StrawsonDesign/EduRover/EduRover Solidworks/BBB Subassembly/BBB subassembly.sldasm

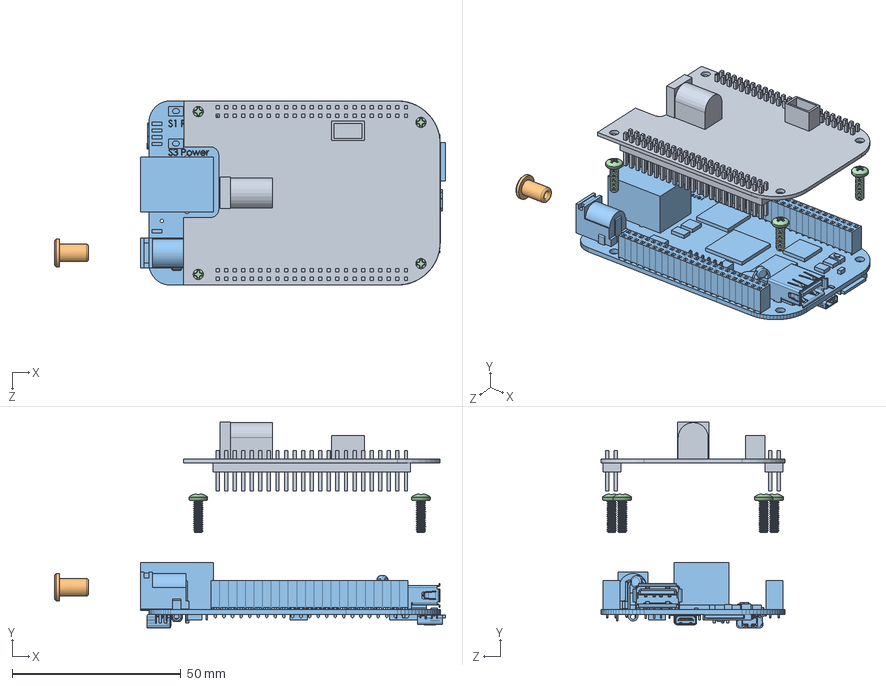
[picture p1: CAD file, 2015-09-28]
EduRover Solidworks/BBB Subassembly/BBB subassembly.sldasm
116.0 x 61.0 x 54.7 mm
SD-101C Robotics Cape
SD-105 DC Plug
BeagleBone Black Detailed
4-40 .375in BHCS McMaster 91772A108 x 4
