StrawsonDesign/EduRover/EduRover Solidworks/Corner Subassembly/corner subassembly with bearing.SLDASM

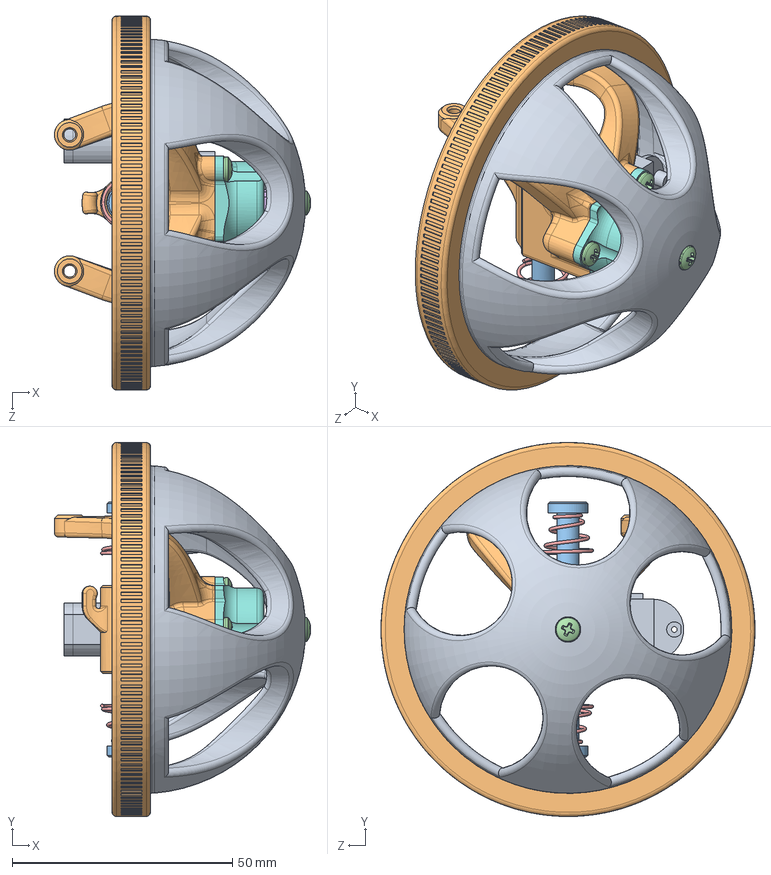
[picture p2: CAD file, 2015-10-05]
EduRover Solidworks/Corner Subassembly/corner subassembly with bearing.SLDASM
58.3 x 85.0 x 85.0 mm
WW Motor
SD-209 Knuckle
M4x20 Low Profile Shoulder Screw 90323A328 x 2
4-40 .375in BHCS McMaster 91772A108 x 4
0.375in conical spring 1692K51 x 2
spline adapter
WW bearing
SD-204 Wheel Bearing Retainer
SD-207 EduRover Wheel
Pololu 90mm Tire
