StrawsonDesign/EduRover/EduRover Solidworks/Servo Subassembly/servo subassembly.SLDASM

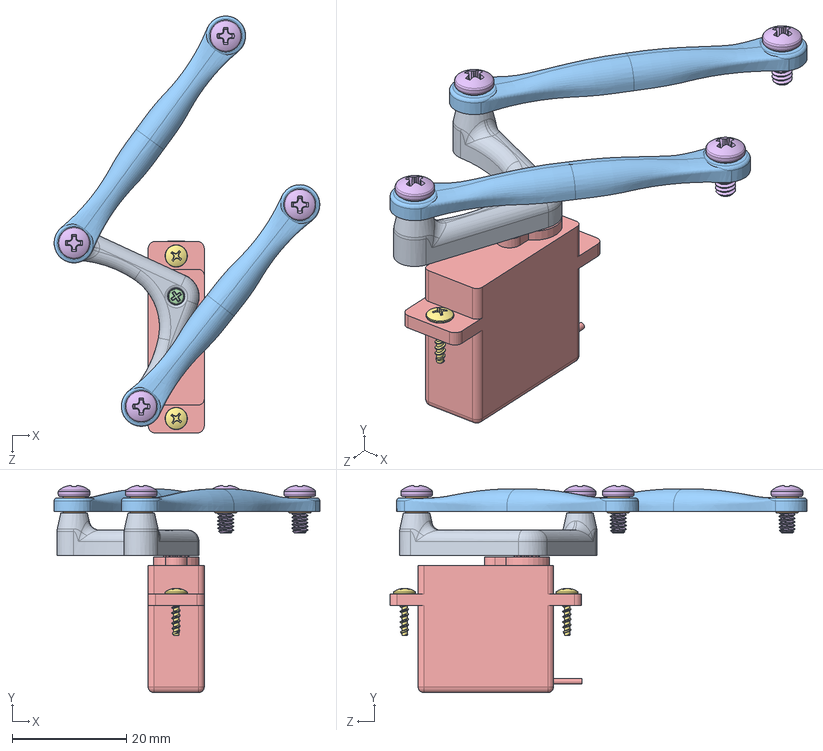
[picture p3: CAD file, 2015-09-28]
EduRover Solidworks/Servo Subassembly/servo subassembly.SLDASM
46.6 x 36.4 x 73.1 mm
SD-206 Servo Horn
ball linkage ball 4 40 x 4
SD-205 Steering Linkage x 2
Hitec servo screw
Hitec HS-45HB
4-40 0.25in BHCS McMaster 91772A106 x 4
Hitec Mounting Screws ROUGH x 2
