StrawsonDesign/EduRover/EduRover Solidworks/accessories/accessories.SLDASM

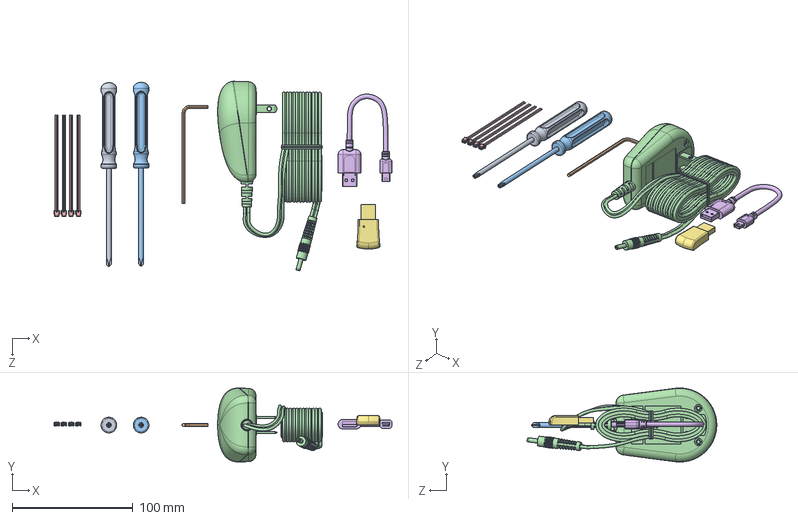
[picture p4: CAD file, 2015-09-28]
EduRover Solidworks/accessories/accessories.SLDASM
280.1 x 61.3 x 157.1 mm
Philips Screwdriver P2
2.5mm allan key
Philips Screwdriver P0
12v 1A DC power supply
JST ZH 2-Pin Pigtail x 4
mini usb cable
Bluetooth Dongle
