StrawsonDesign/EduRover/EduRover Solidworks/Chassis Subassembly/chassis subassembly.SLDASM

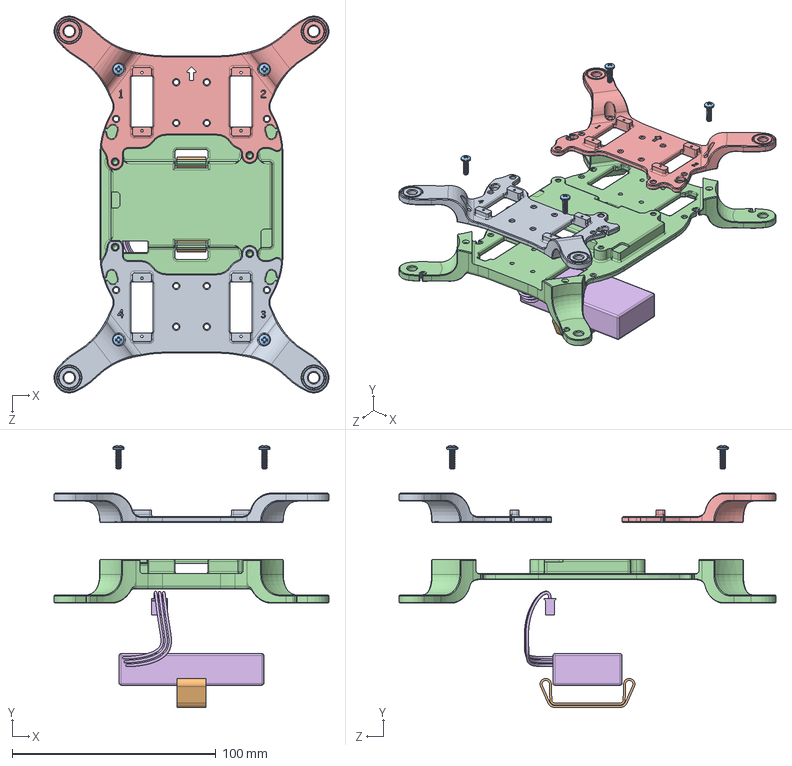
[picture p5: CAD file, 2015-09-28]
EduRover Solidworks/Chassis Subassembly/chassis subassembly.SLDASM
135.0 x 128.7 x 185.0 mm
SD-203 Chassis Back
velcro strap
4-40 .375in BHCS McMaster 91772A108 x 4
SD-202 Chassis Bottom
SD-201 Chassis Front
EduLine 1400mah Battery
