StrawsonDesign/EduRover/EduRover Solidworks/Servo Subassembly/ball linkage 4 40.SLDASM

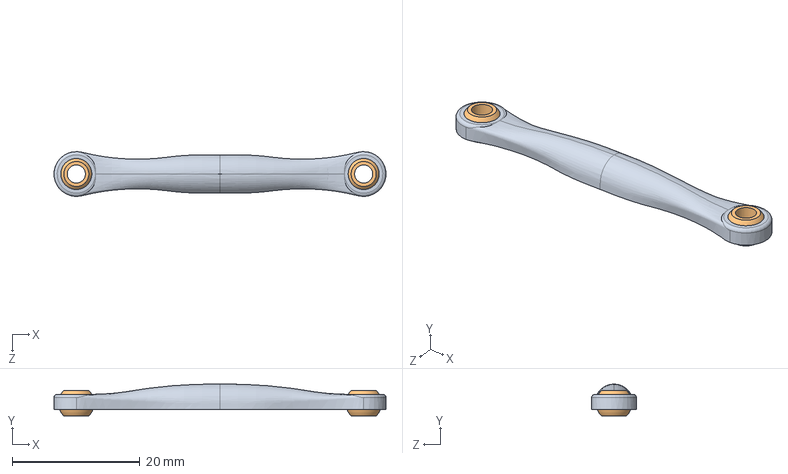
[picture p6: CAD file, 2015-09-28]
EduRover Solidworks/Servo Subassembly/ball linkage 4 40.SLDASM
52.0 x 5.00 x 7.00 mm
ball linkage ball 4 40 x 2
SD-205 Steering Linkage
