StrawsonDesign/EduRover/EduRover Solidworks/accessories/JST ZH 2-Pin Pigtail.SLDPRT

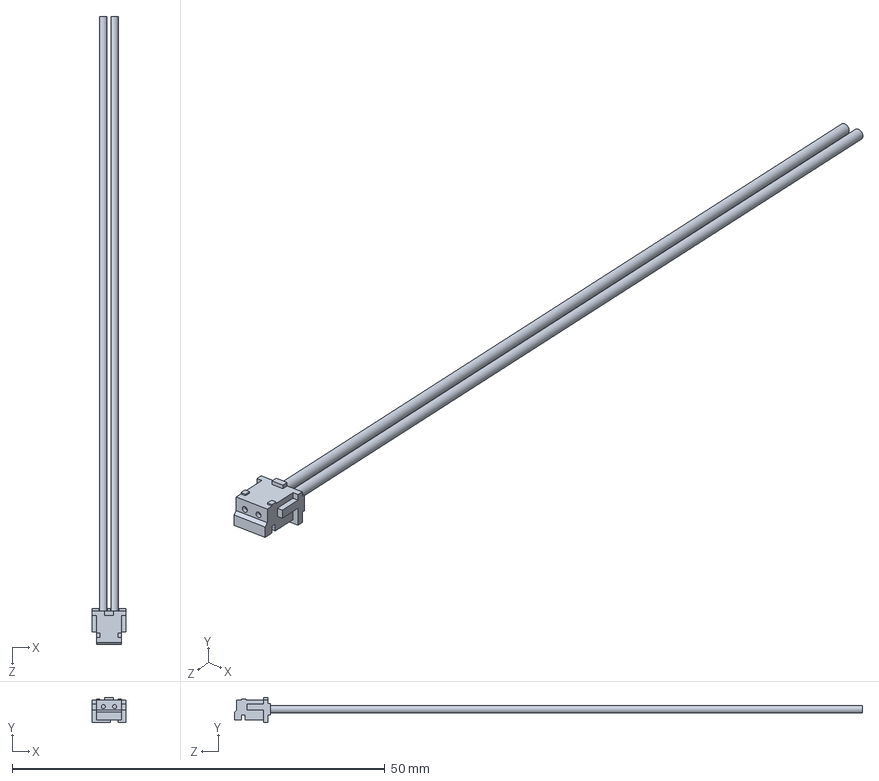
[picture p7: CAD file, 2015-09-28]
EduRover Solidworks/accessories/JST ZH 2-Pin Pigtail.SLDPRT
4.50 x 3.40 x 84.2 mm
