StrawsonDesign/EduRover/EduRover Solidworks/Chassis Subassembly/EduLine 1400mah Battery.SLDPRT

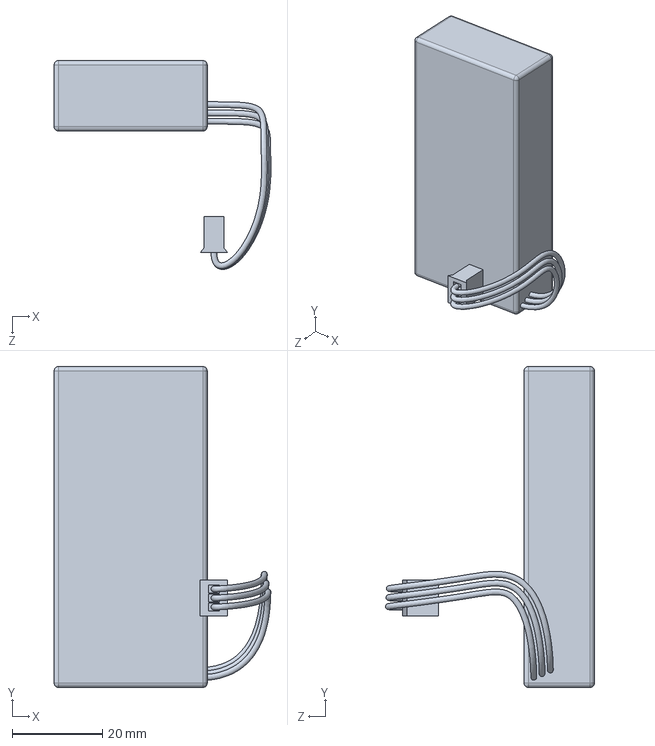
[picture p8: CAD file, 2015-09-28]
EduRover Solidworks/Chassis Subassembly/EduLine 1400mah Battery.SLDPRT
48.0 x 71.0 x 46.2 mm
