StrawsonDesign/EduRover/EduRover Solidworks/hardware/MiP bearing.SLDPRT

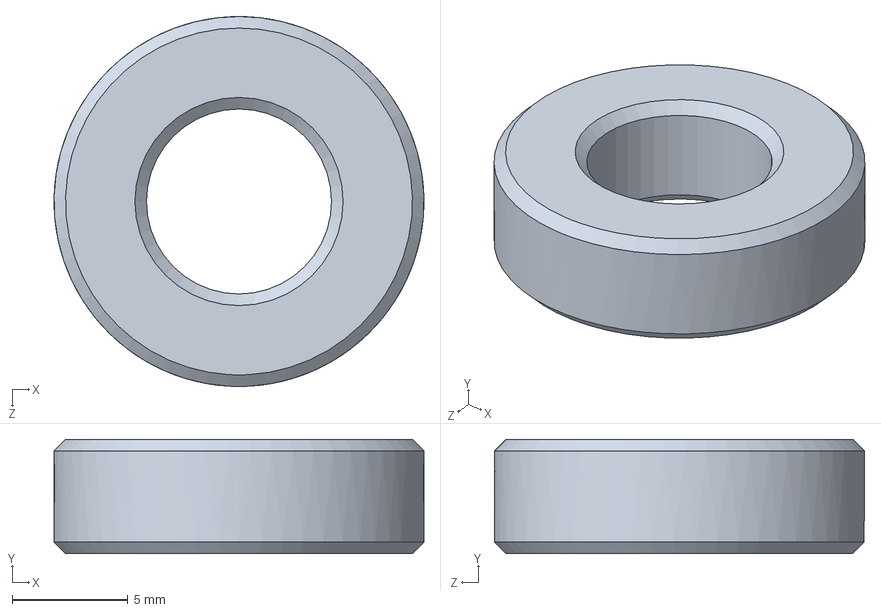
[picture p9: CAD file, 2015-09-28]
EduRover Solidworks/hardware/MiP bearing.SLDPRT
16.0 x 4.95 x 16.0 mm
