StrawsonDesign/EduRover/EduRover STL for printing/SD-209 Knuckle.STL

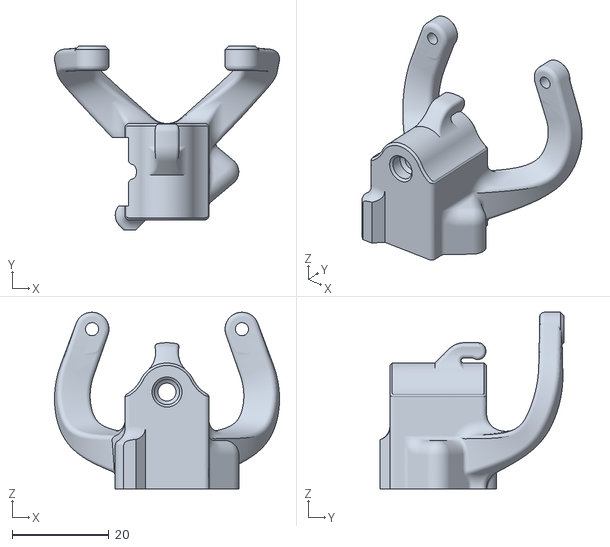
[picture p10: CAD file, 2015-10-05]
EduRover STL for printing/SD-209 Knuckle.STL
46.5 x 38.0 x 36.5
