StrawsonDesign/EduRover/EduRover Solidworks/accessories/2.5mm allan key.SLDPRT

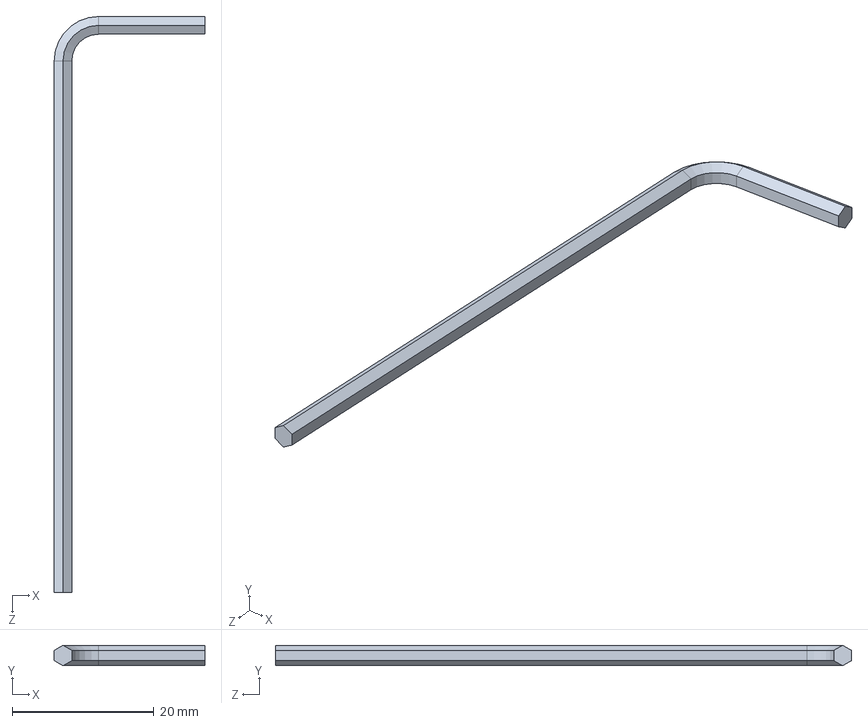
[picture p11: CAD file, 2015-09-28]
EduRover Solidworks/accessories/2.5mm allan key.SLDPRT
21.2 x 2.89 x 81.2 mm
