StrawsonDesign/EduRover/EduRover Solidworks/BBB Subassembly/SD-101C Robotics Cape.SLDPRT

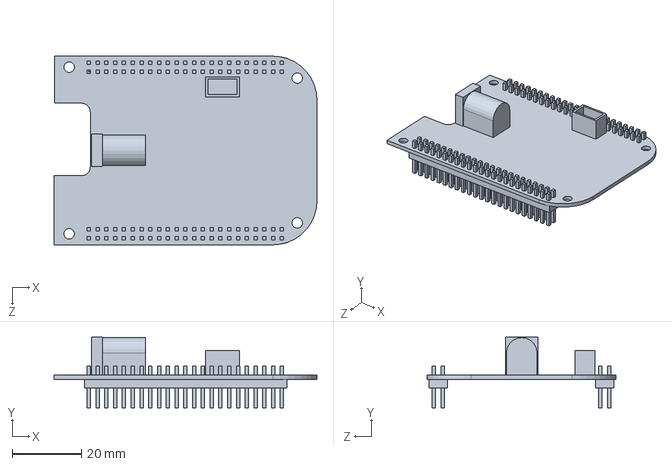
[picture p12: CAD file, 2015-09-28]
EduRover Solidworks/BBB Subassembly/SD-101C Robotics Cape.SLDPRT
76.1 x 20.5 x 54.6 mm
