StrawsonDesign/EduRover/EduRover Solidworks/Chassis Subassembly/velcro strap.SLDPRT

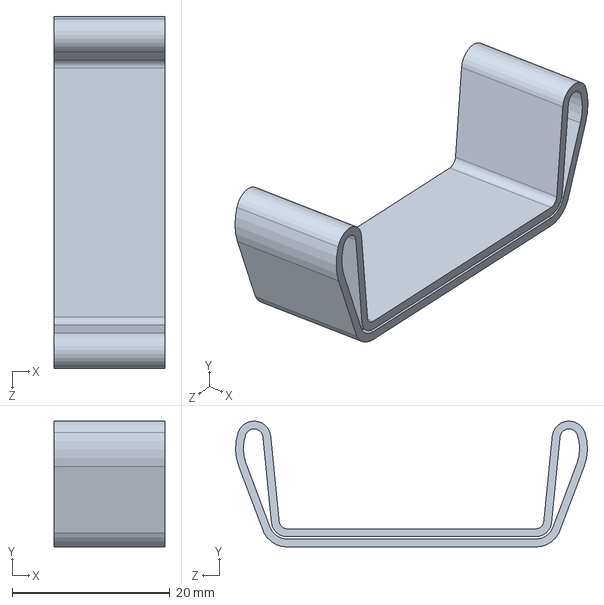
[picture p13: CAD file, 2015-09-28]
EduRover Solidworks/Chassis Subassembly/velcro strap.SLDPRT
14.0 x 15.9 x 44.6 mm
