StrawsonDesign/EduRover/EduRover Solidworks/Servo Subassembly/Hitec HS-45HB.SLDPRT

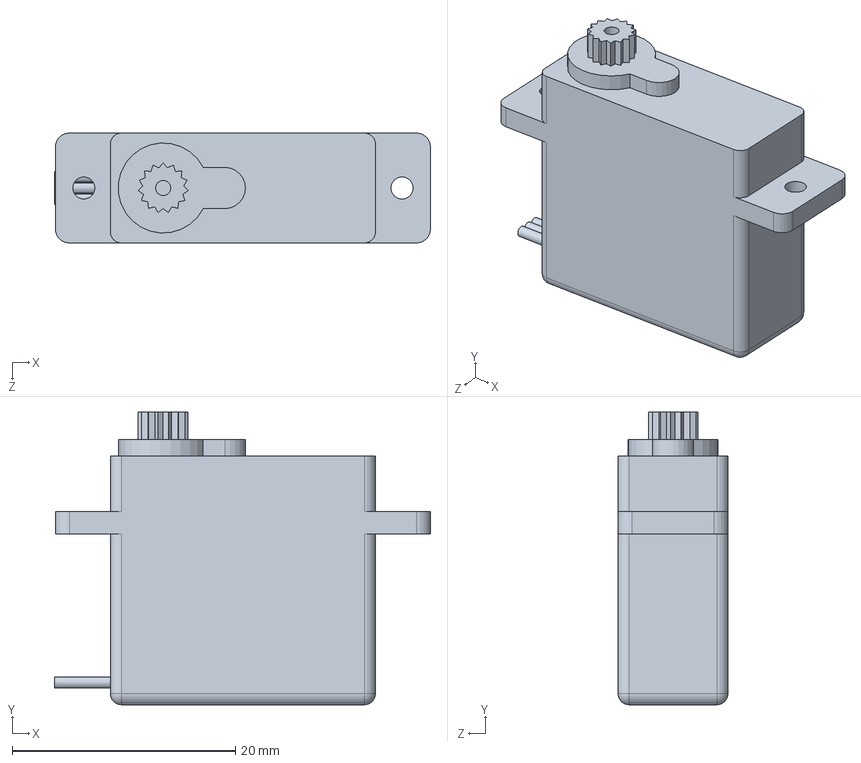
[picture p14: CAD file, 2015-09-28]
EduRover Solidworks/Servo Subassembly/Hitec HS-45HB.SLDPRT
33.7 x 26.2 x 9.85 mm
