StrawsonDesign/EduRover/EduRover STL for printing/SD-205 Steering Linkage.STL

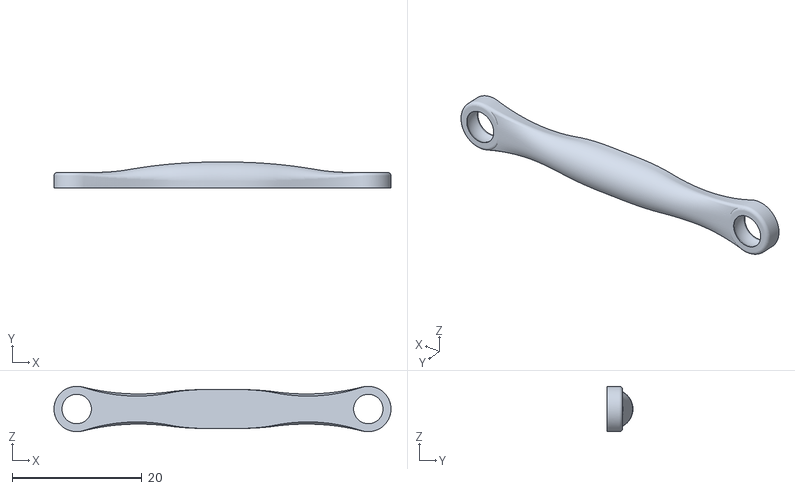
[picture p15: CAD file, 2015-09-28]
EduRover STL for printing/SD-205 Steering Linkage.STL
52.0 x 4.00 x 7.00
