StrawsonDesign/EduRover/EduRover Solidworks/accessories/3mm allan key.SLDPRT

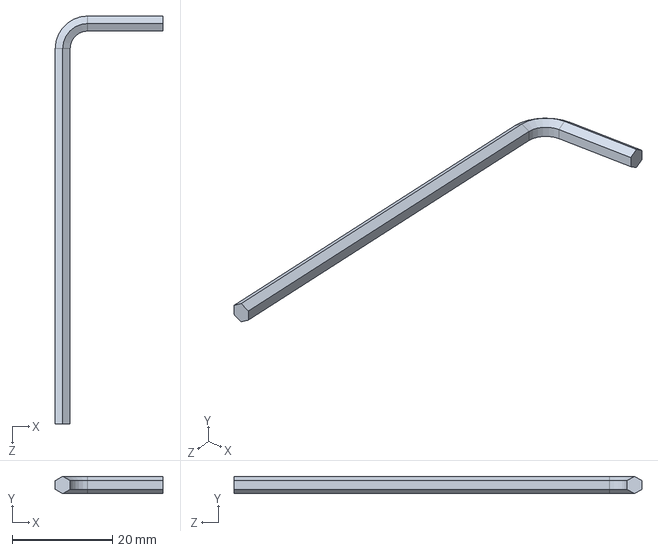
[picture p16: CAD file, 2015-09-28]
EduRover Solidworks/accessories/3mm allan key.SLDPRT
21.5 x 3.46 x 81.5 mm
