StrawsonDesign/EduRover/EduRover Solidworks/BBB Subassembly/SD-105 DC Plug.SLDPRT

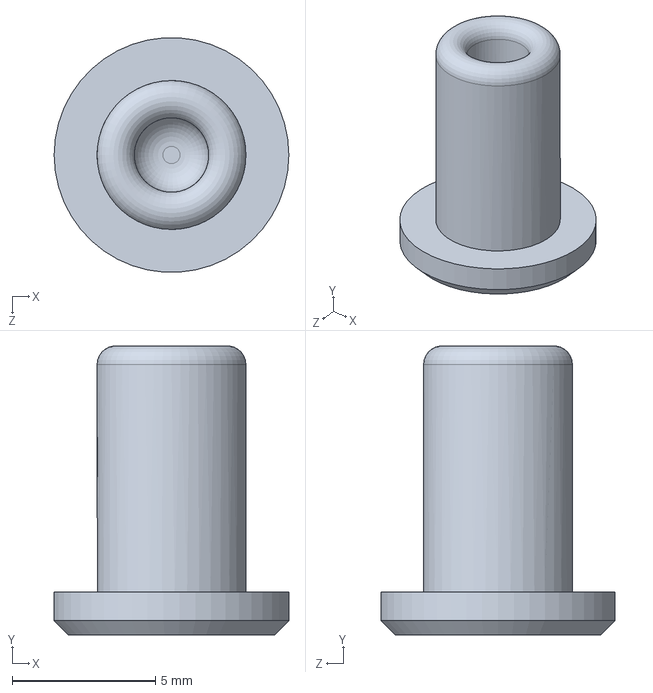
[picture p17: CAD file, 2015-09-28]
EduRover Solidworks/BBB Subassembly/SD-105 DC Plug.SLDPRT
8.20 x 10.1 x 8.18 mm
