StrawsonDesign/EduRover/EduRover Solidworks/Chassis Subassembly/SD-201 Chassis Front.SLDPRT

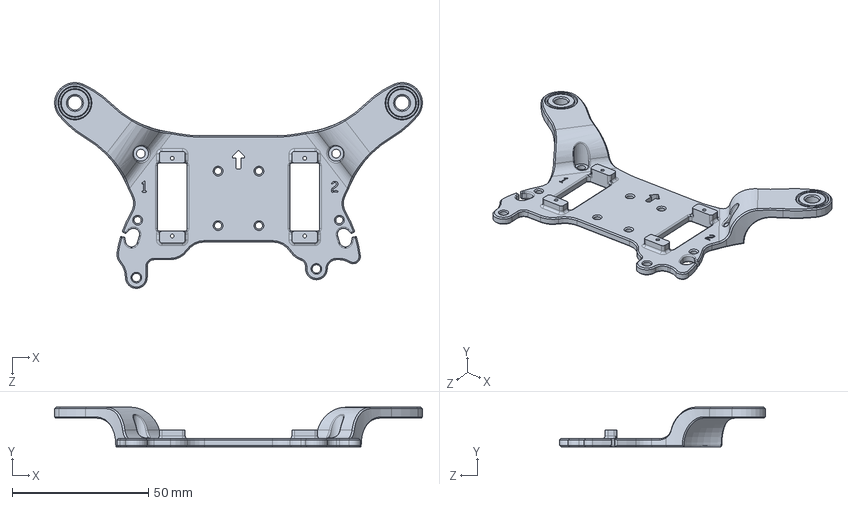
[picture p18: CAD file, 2015-09-28]
EduRover Solidworks/Chassis Subassembly/SD-201 Chassis Front.SLDPRT
135.0 x 14.5 x 75.5 mm
