StrawsonDesign/EduRover/EduRover Solidworks/Corner Subassembly/WW bearing.SLDPRT

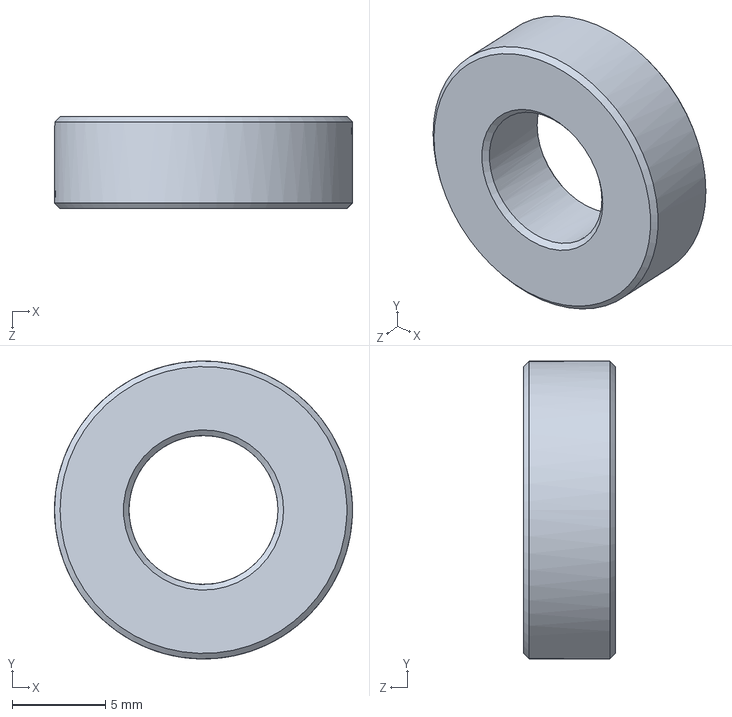
[picture p19: CAD file, 2015-09-28]
EduRover Solidworks/Corner Subassembly/WW bearing.SLDPRT
16.0 x 16.0 x 4.95 mm
