StrawsonDesign/EduRover/EduRover Solidworks/hardware/0.375in conical spring 1692K510.SLDPRT

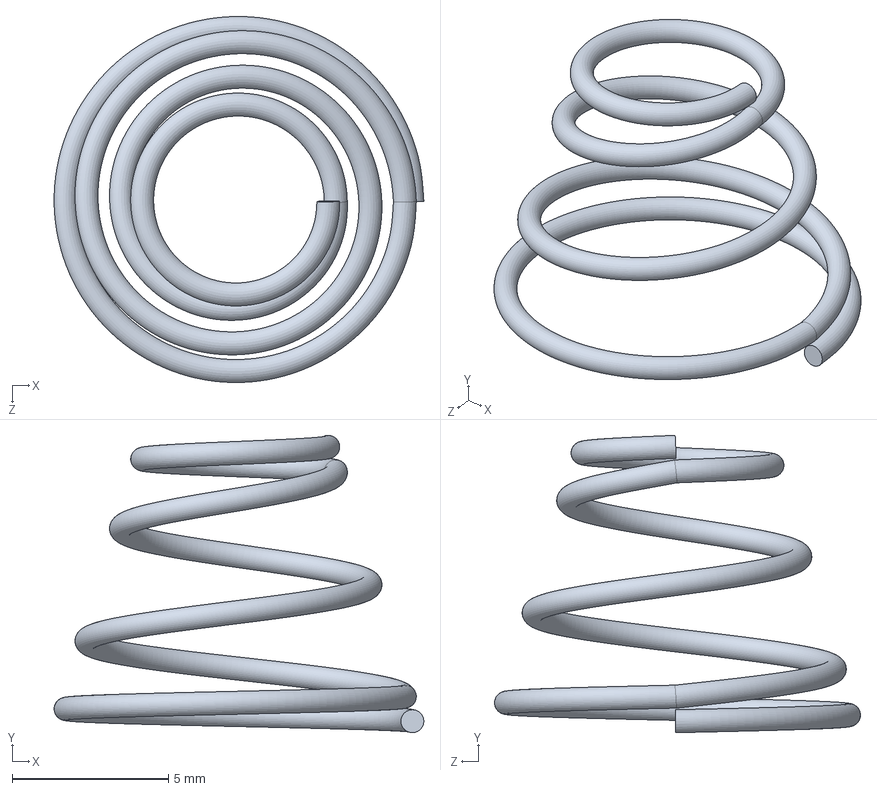
[picture p20: CAD file, 2015-09-28]
EduRover Solidworks/hardware/0.375in conical spring 1692K510.SLDPRT
11.8 x 9.53 x 11.7 mm
