StrawsonDesign/EduRover/EduRover Solidworks/Servo Subassembly/SD-206 Servo Horn.SLDPRT

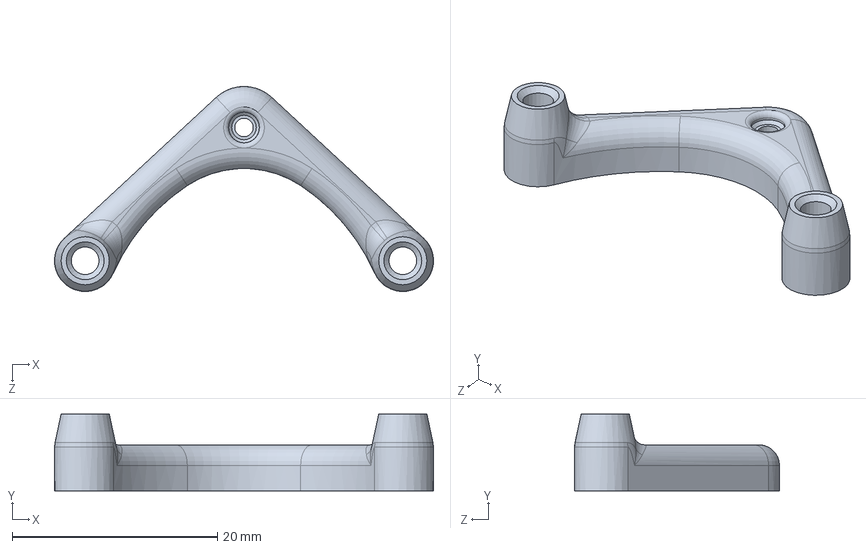
[picture p21: CAD file, 2015-09-28]
EduRover Solidworks/Servo Subassembly/SD-206 Servo Horn.SLDPRT
37.0 x 7.50 x 20.0 mm
