StrawsonDesign/EduRover/EduRover STL for printing/SD-203 Chassis Back.STL

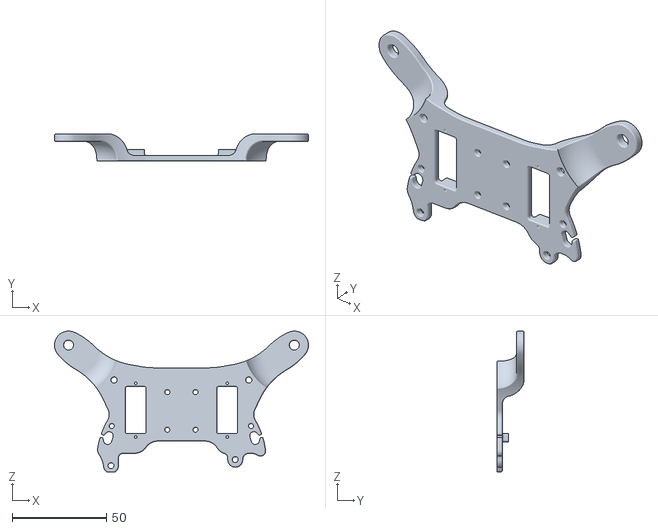
[picture p22: CAD file, 2015-09-28]
EduRover STL for printing/SD-203 Chassis Back.STL
135.0 x 14.5 x 74.8
