StrawsonDesign/EduRover/EduRover Solidworks/Chassis Subassembly/Turnigy Nanotech 1300mah 2S N1300.2S.25.SLDPRT

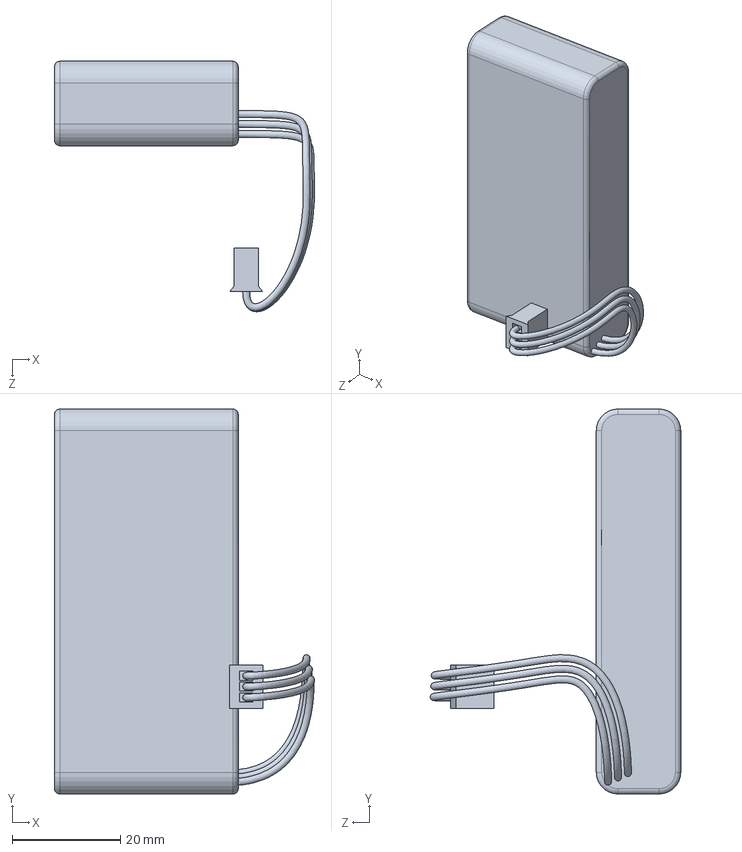
[picture p23: CAD file, 2015-09-28]
EduRover Solidworks/Chassis Subassembly/Turnigy Nanotech 1300mah 2S N1300.2S.25.SLDPRT
48.0 x 71.0 x 46.2 mm
