StrawsonDesign/EduRover/EduRover Solidworks/Corner Subassembly/SD-207 EduRover Wheel.SLDPRT

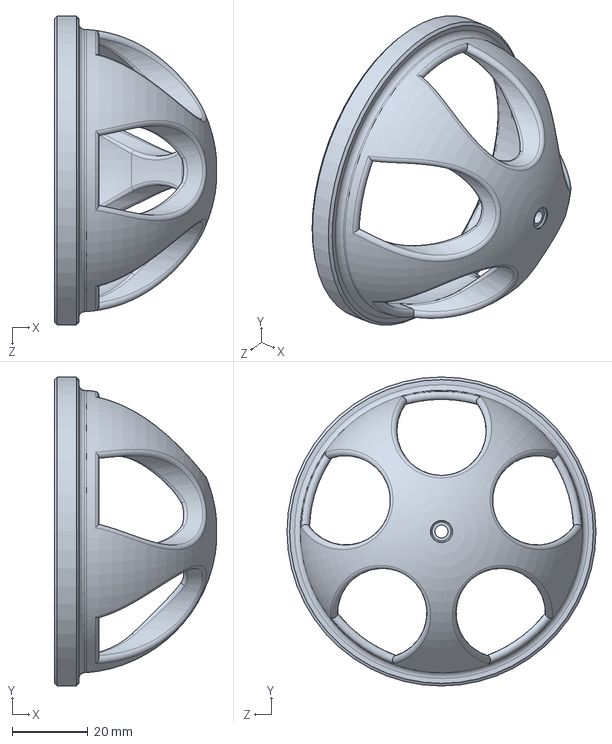
[picture p24: CAD file, 2015-09-28]
EduRover Solidworks/Corner Subassembly/SD-207 EduRover Wheel.SLDPRT
42.8 x 81.4 x 81.4 mm
