StrawsonDesign/EduRover/EduRover STL for printing/SD-204 Wheel Bearing Retainer.STL

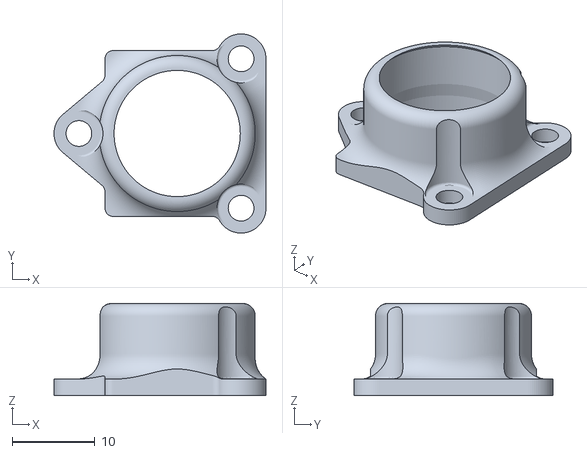
[picture p25: CAD file, 2015-09-28]
EduRover STL for printing/SD-204 Wheel Bearing Retainer.STL
25.5 x 24.0 x 11.1
