StrawsonDesign/EduRover/EduRover Solidworks/accessories/12v 1A DC power supply.SLDPRT

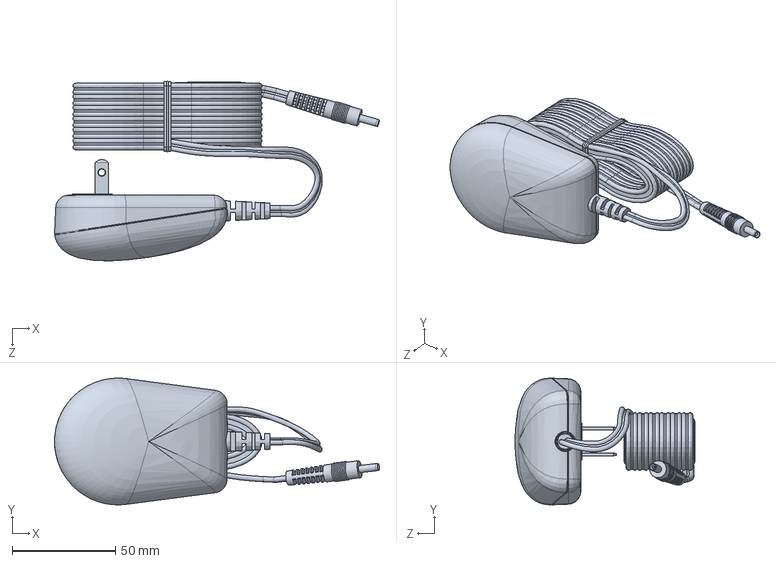
[picture p26: CAD file, 2015-09-28]
EduRover Solidworks/accessories/12v 1A DC power supply.SLDPRT
157.1 x 61.3 x 87.0 mm
