StrawsonDesign/EduRover/EduRover Solidworks/Corner Subassembly/WW Motor.SLDPRT

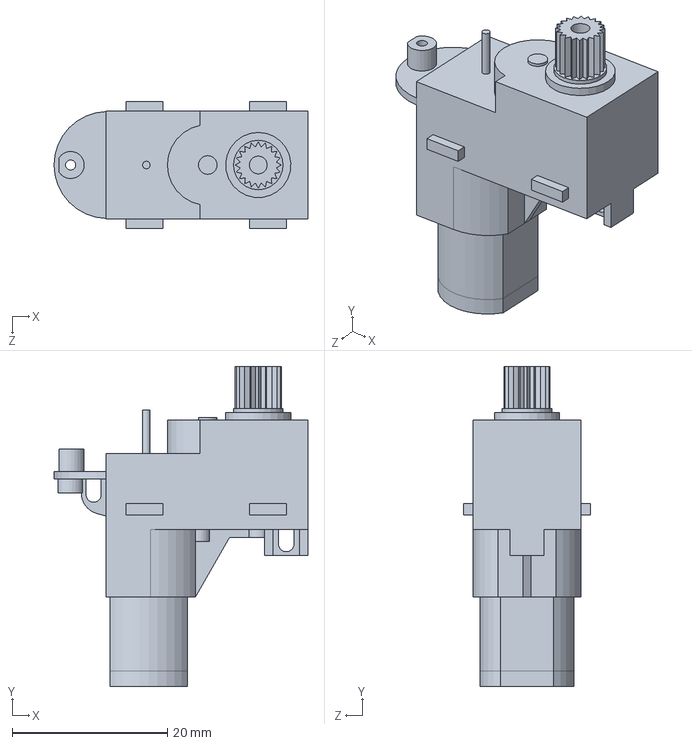
[picture p27: CAD file, 2015-09-28]
EduRover Solidworks/Corner Subassembly/WW Motor.SLDPRT
32.7 x 41.2 x 16.3 mm
