StrawsonDesign/EduRover/EduRover Solidworks/Servo Subassembly/ball linkage ball 4 40.SLDPRT

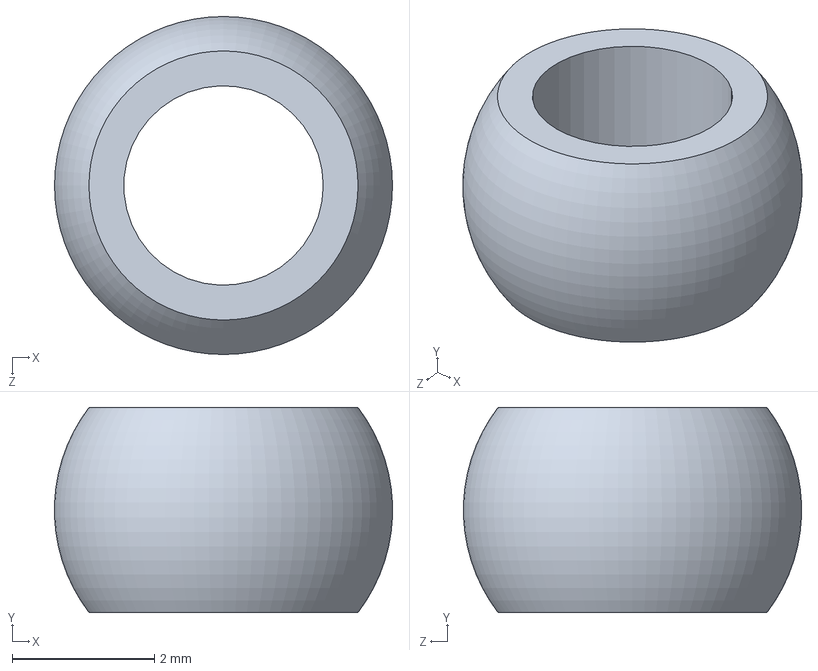
[picture p28: CAD file, 2015-09-28]
EduRover Solidworks/Servo Subassembly/ball linkage ball 4 40.SLDPRT
4.75 x 2.88 x 4.75 mm
