StrawsonDesign/EduRover/EduRover Solidworks/accessories/Bluetooth Dongle.SLDPRT

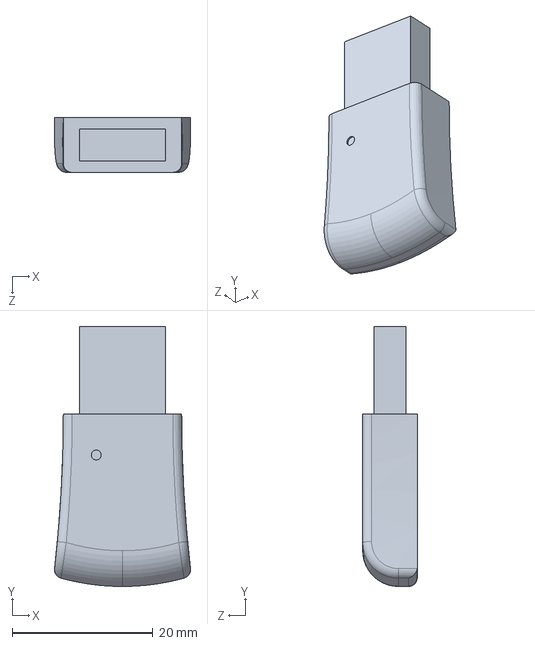
[picture p29: CAD file, 2015-09-28]
EduRover Solidworks/accessories/Bluetooth Dongle.SLDPRT
19.3 x 36.9 x 7.77 mm
