StrawsonDesign/EduRover/EduRover Solidworks/Corner Subassembly/Pololu 90mm Tire.SLDPRT

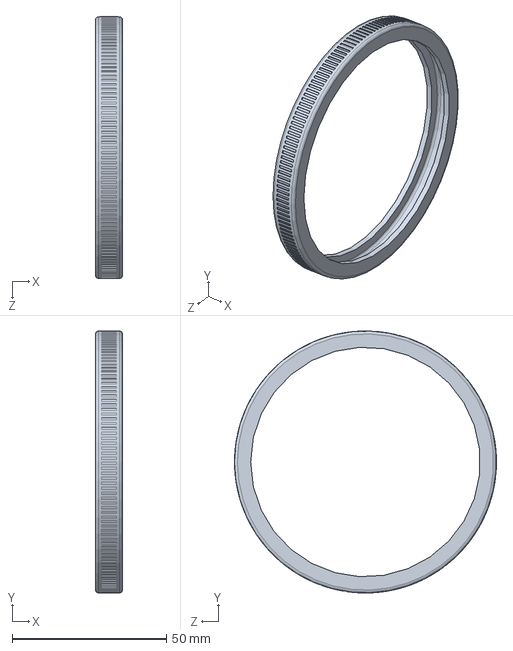
[picture p30: CAD file, 2015-09-28]
EduRover Solidworks/Corner Subassembly/Pololu 90mm Tire.SLDPRT
8.75 x 85.0 x 85.0 mm
