StrawsonDesign/EduRover/EduRover Solidworks/accessories/mini usb cable.SLDPRT

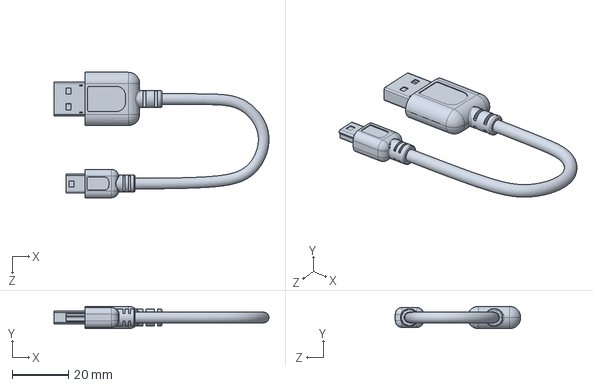
[picture p31: CAD file, 2015-09-28]
EduRover Solidworks/accessories/mini usb cable.SLDPRT
76.6 x 8.00 x 44.7 mm
