StrawsonDesign/EduRover/EduRover Solidworks/Chassis Subassembly/SD-202 Chassis Bottom.sldprt

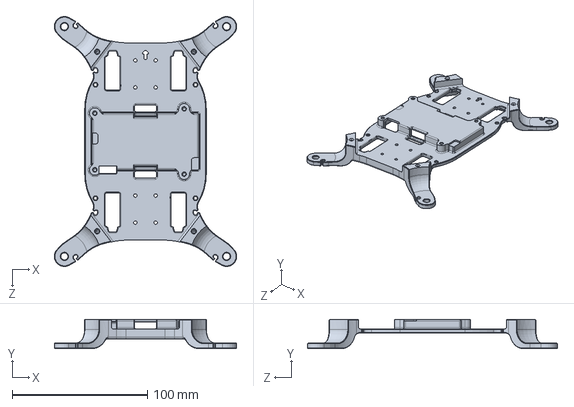
[picture p32: CAD file, 2015-09-28]
EduRover Solidworks/Chassis Subassembly/SD-202 Chassis Bottom.sldprt
135.0 x 21.5 x 185.0 mm
