StrawsonDesign/EduRover/EduRover Solidworks/Corner Subassembly/spline adapter.SLDPRT

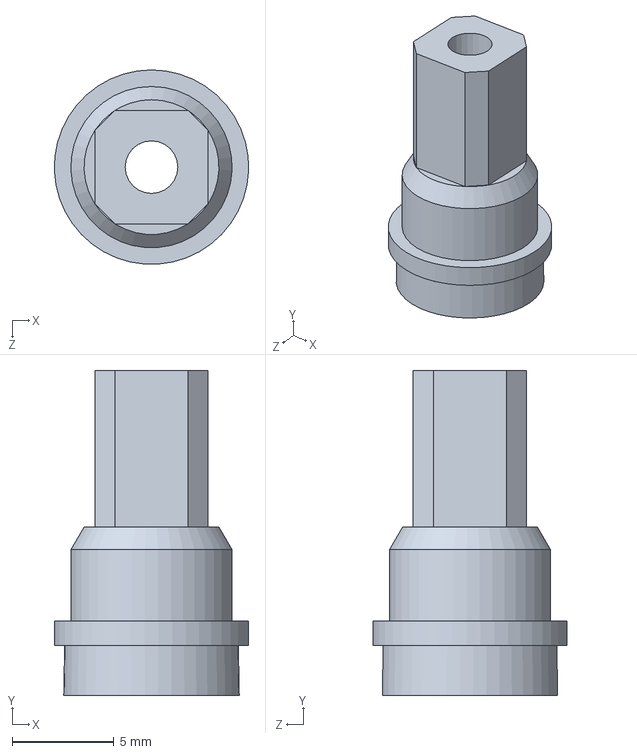
[picture p33: CAD file, 2015-09-28]
EduRover Solidworks/Corner Subassembly/spline adapter.SLDPRT
9.56 x 16.0 x 9.56 mm
