StrawsonDesign/EduRover/(list of files, cad)

Other CAD files:
EduRover Solidworks/Corner Subassembly/SD-209 Knuckle.SLDPRT
EduRover Solidworks/Servo Subassembly/SD-205 Steering Linkage.SLDPRT
EduRover STL for printing/SD-105 DC Plug.STL
EduRover Solidworks/Chassis Subassembly/SD-203 Chassis Back.sldprt
EduRover STL for printing/SD-206 Servo Horn.STL
EduRover STL for printing/SD-201 Chassis Front.STL
EduRover Solidworks/Corner Subassembly/SD-204 Wheel Bearing Retainer.SLDPRT
EduRover Solidworks/hardware/0.375in conical spring 1692K51.SLDPRT
EduRover Solidworks/EduRover Drawing.SLDDRW
EduRover Solidworks/Old Unused parts/2000mah LiPo battery.SLDPRT
EduRover Solidworks/Old Unused parts/BeagleBone Black Rough.SLDPRT
EduRover Solidworks/Old Unused parts/Hub.SLDPRT
EduRover Solidworks/Old Unused parts/cable wrap standoff.SLDPRT
EduRover Solidworks/Old Unused parts/chassis standoffs.SLDPRT
EduRover Solidworks/Old Unused parts/encoder board new for Rover.SLDPRT
EduRover Solidworks/Old Unused parts/encoder board.SLDPRT
EduRover Solidworks/Old Unused parts/encoder wheels.SLDPRT
EduRover Solidworks/Old Unused parts/new encoder wheel.SLDPRT
EduRover Solidworks/Servo Subassembly/Hitec Mounting Screws ROUGH.SLDPRT
EduRover Solidworks/accessories/Philips Screwdriver P0.SLDPRT
EduRover Solidworks/accessories/Philips Screwdriver P2.SLDPRT
EduRover Solidworks/hardware/4-40 .375in BHCS McMaster 91772A108.SLDPRT
EduRover Solidworks/hardware/4-40 0.25in BHCS McMaster 91772A106.SLDPRT
EduRover Solidworks/hardware/Hitec servo screw.SLDPRT
EduRover Solidworks/hardware/M4 x 16mm Low Profile SHoulder Screw 90323A327.SLDPRT
EduRover Solidworks/hardware/M4x20 Low Profile Shoulder Screw 90323A328.SLDPRT
EduRover Solidworks/hardware/servo washer.SLDPRT
