StrawsonDesign/EduRover/EduRover Drawing.PDF

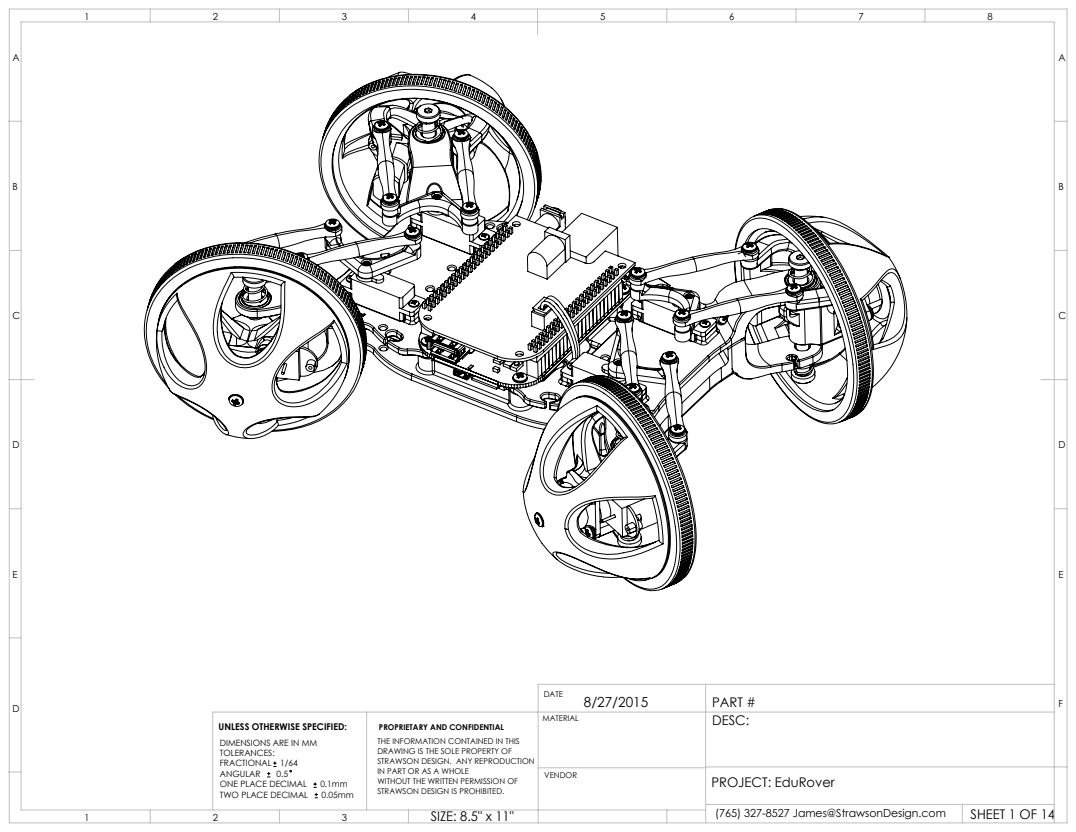
[picture p34: page 1]
SIZE: 8.5" x 11"; SHEET 1 OF 14

DATE 8/27/2015 | PART #

UNLESS OTHERWISE SPECIFIED: DIMENSIONS ARE IN MM TOLERANCES: FRACTIONAL 1/64 ANGULAR 0.5 ONE PLACE DECIMAL 0.1mm TWO PLACE DECIMAL 0.05mm | PROPRIETARY AND CONFIDENTIAL THE INFORMATION CONTAINED IN THIS DRAWING IS THE SOLE PROPERTY OF STRAWSON DESIGN. ANY REPRODUCTION IN PART OR AS A WHOLE WITHOUT THE WRITTEN PERMISSION OF STRAWSON DESIGN IS PROHIBITED. | MATERIAL | DESC:

VENDOR | PROJECT: EduRover

(765) 327-8527 James@StrawsonDesign.com

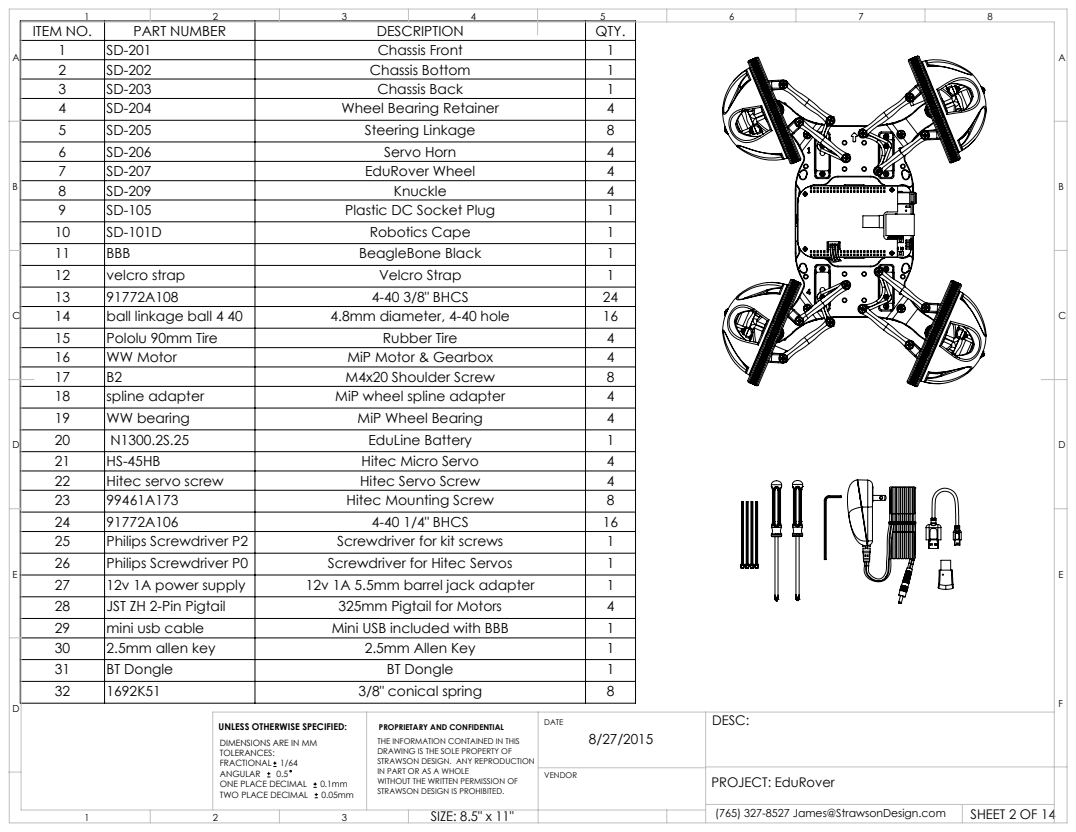
[picture p35: page 2]
ITEM NO.; PART NUMBER; DESCRIPTION; QTY.; SHEET 2 OF 14

1 | SD-201 | Chassis Front | 1
2 | SD-202 | Chassis Bottom | 1
3 | SD-203 | Chassis Back | 1
4 | SD-204 | Wheel Bearing Retainer | 4
B | 5 | SD-205 | Steering Linkage | 8 | B
6 | SD-206 | Servo Horn | 4
7 | SD-207 | EduRover Wheel | 4
8 | SD-209 | Knuckle | 4
9 | SD-105 | Plastic DC Socket Plug | 1
10 | SD-101D | Robotics Cape | 1
11 | BBB | BeagleBone Black | 1
12 | velcro strap | Velcro Strap | 1
13 | 91772A108 | 4-40 3/8" BHCS | 24
14 | ball linkage ball 4 40 | 4.8mm diameter, 4-40 hole | 16
15 | Pololu 90mm Tire | Rubber Tire | 4
16 | WW Motor | MiP Motor & Gearbox | 4
17 | B2 | M4x20 Shoulder Screw | 8
18 | spline adapter | MiP wheel spline adapter | 4
19 | WW bearing | MiP Wheel Bearing | 4
20 | N1300.2S.25 | EduLine Battery | 1
21 | HS-45HB | Hitec Micro Servo | 4
22 | Hitec servo screw | Hitec Servo Screw | 4
23 | 99461A173 | Hitec Mounting Screw | 8
E | 24 | 91772A106 | 4-40 1/4" BHCS | 16
25 | Philips Screwdriver P2 | Screwdriver for kit screws | 1
26 | Philips Screwdriver P0 | Screwdriver for Hitec Servos | 1
27 | 12v 1A power supply | 12v 1A 5.5mm barrel jack adapter | 1
28 | JST ZH 2-Pin Pigtail | 325mm Pigtail for Motors | 4
29 | mini usb cable | Mini USB included with BBB | 1
D | 30 | 2.5mm allen key | 2.5mm Allen Key | 1
31 | BT Dongle | BT Dongle | 1
32 | 1692K51 | 3/8" conical spring | 8

UNLESS OTHERWISE SPECIFIED:
DIMENSIONS ARE IN MM
TOLERANCES:
FRACTIONAL 1/64

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

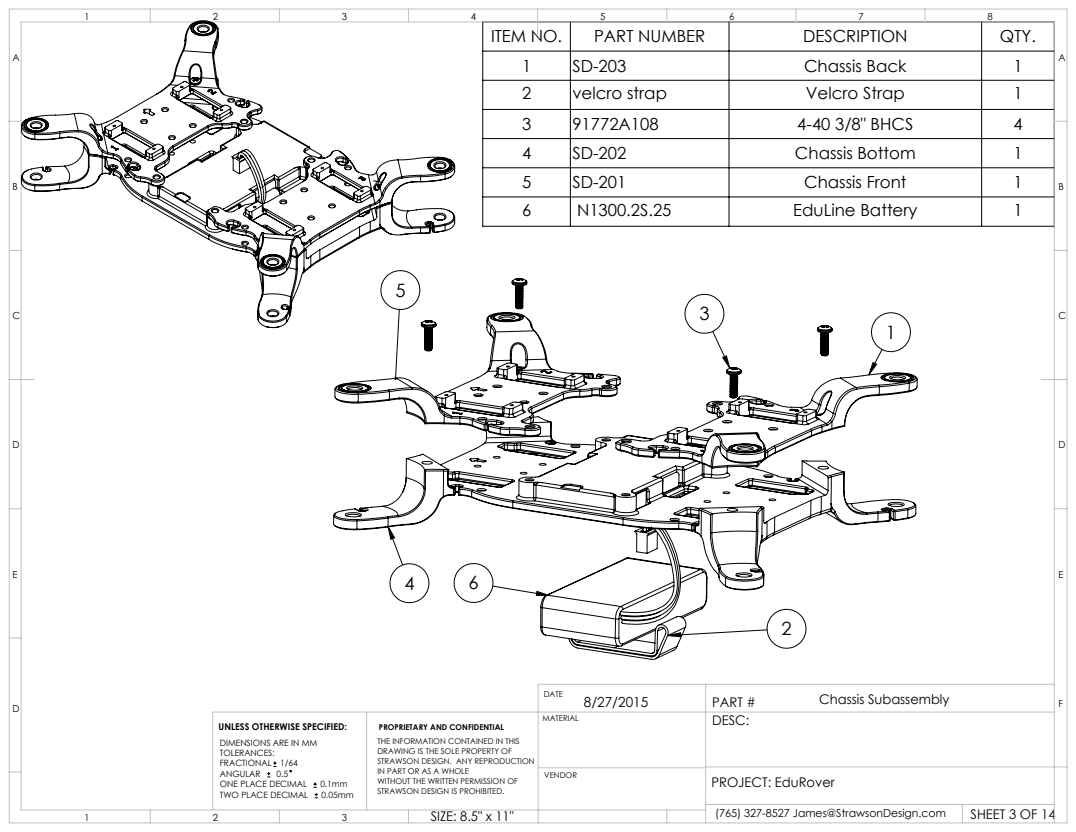
[picture p36: page 3]
SHEET 3 OF 14

1 | SD-203 | Chassis Back | 1
2 | velcro strap | Velcro Strap | 1
3 | 91772A108 | 4-40 3/8" BHCS | 4
4 | SD-202 | Chassis Bottom | 1
5 | SD-201 | Chassis Front | 1
6 | N1300.2S.25 | EduLine Battery | 1

DATE 8/27/2015 | Chassis Subassembly PART #

UNLESS OTHERWISE SPECIFIED: DIMENSIONS ARE IN MM TOLERANCES: FRACTIONAL 1/64 | PROPRIETARY AND CONFIDENTIAL THE INFORMATION CONTAINED IN THIS DRAWING IS THE SOLE PROPERTY OF STRAWSON DESIGN. ANY REPRODUCTION | MATERIAL | DESC:

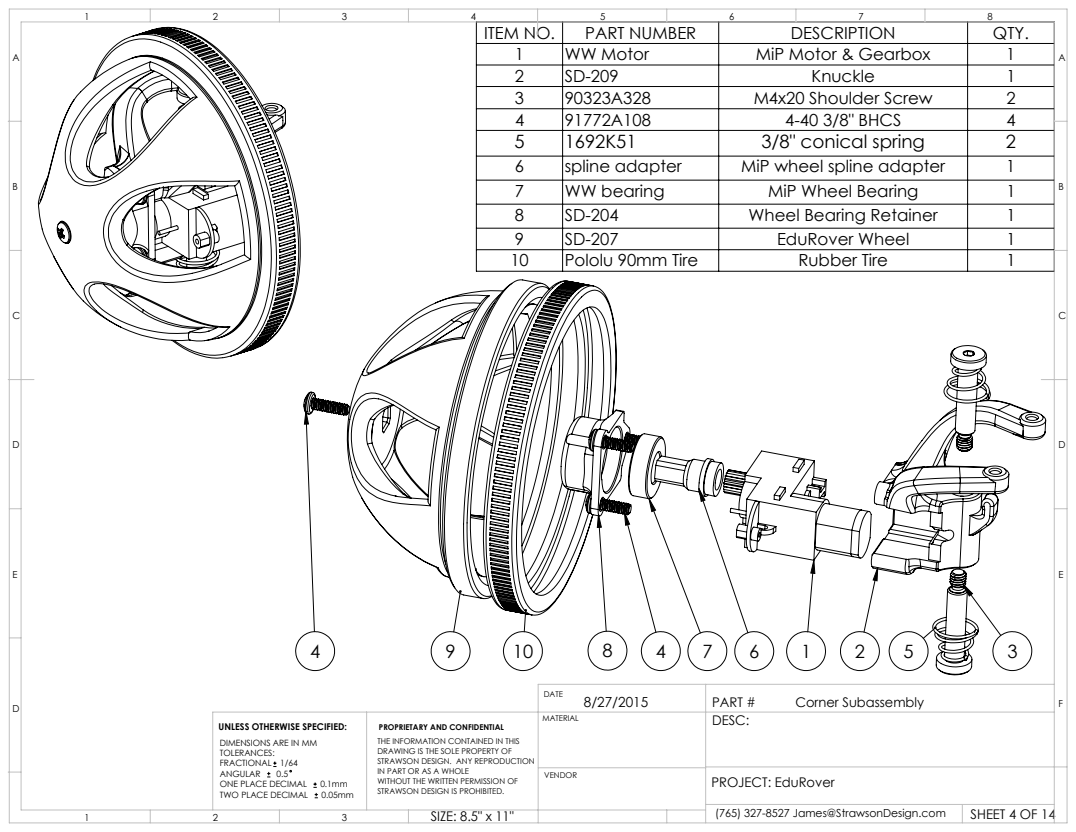
[picture p37: page 4]
SHEET 4 OF 14

1 | WW Motor | MiP Motor & Gearbox | 1
2 | SD-209 | Knuckle | 1
3 | 90323A328 | M4x20 Shoulder Screw | 2
4 | 91772A108 | 4-40 3/8" BHCS | 4
5 | 1692K51 | 3/8" conical spring | 2
6 | spline adapter | MiP wheel spline adapter | 1
7 | WW bearing | MiP Wheel Bearing | 1
8 | SD-204 | Wheel Bearing Retainer | 1
9 | SD-207 | EduRover Wheel | 1
10 | Pololu 90mm Tire | Rubber Tire | 1

DATE 8/27/2015 | Corner Subassembly PART #

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

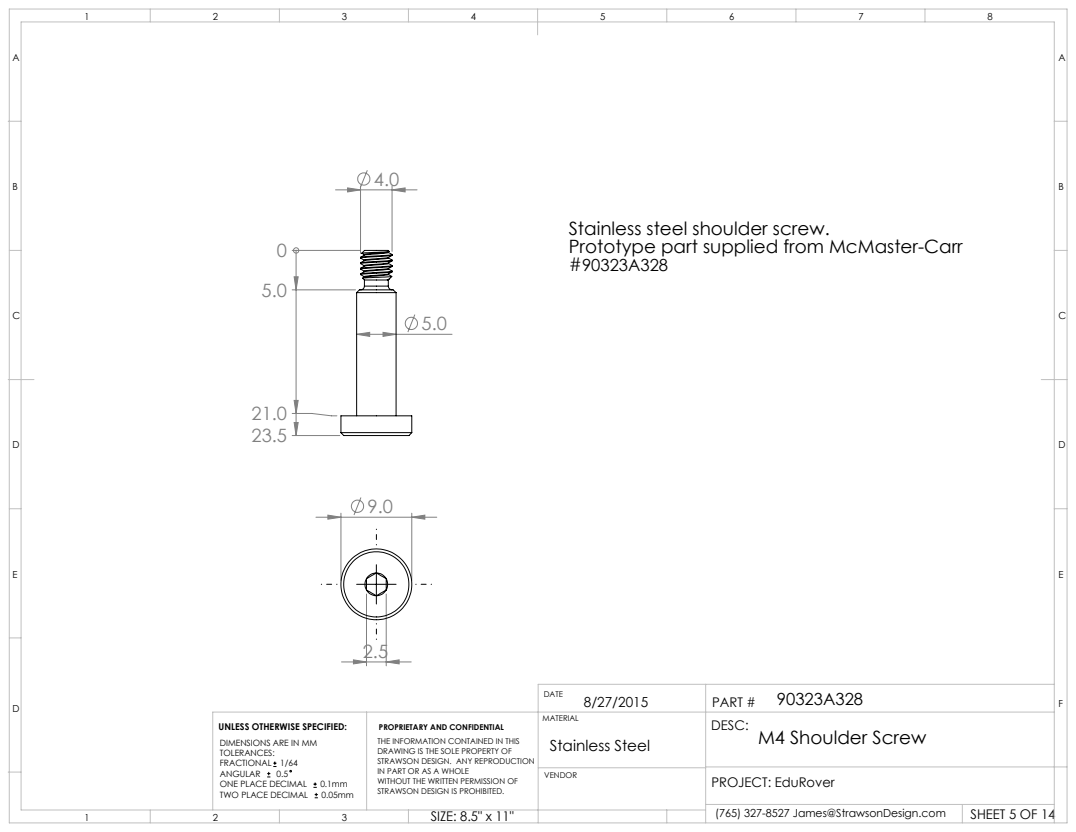
[picture p38: page 5]
SHEET 5 OF 14

Stainless steel shoulder screw.
Prototype part supplied from McMaster-Carr

DATE 8/27/2015 | 90323A328 PART #

UNLESS OTHERWISE SPECIFIED: DIMENSIONS ARE IN MM TOLERANCES: FRACTIONAL 1/64 | PROPRIETARY AND CONFIDENTIAL THE INFORMATION CONTAINED IN THIS DRAWING IS THE SOLE PROPERTY OF STRAWSON DESIGN. ANY REPRODUCTION | MATERIAL Stainless Steel | DESC: M4 Shoulder Screw

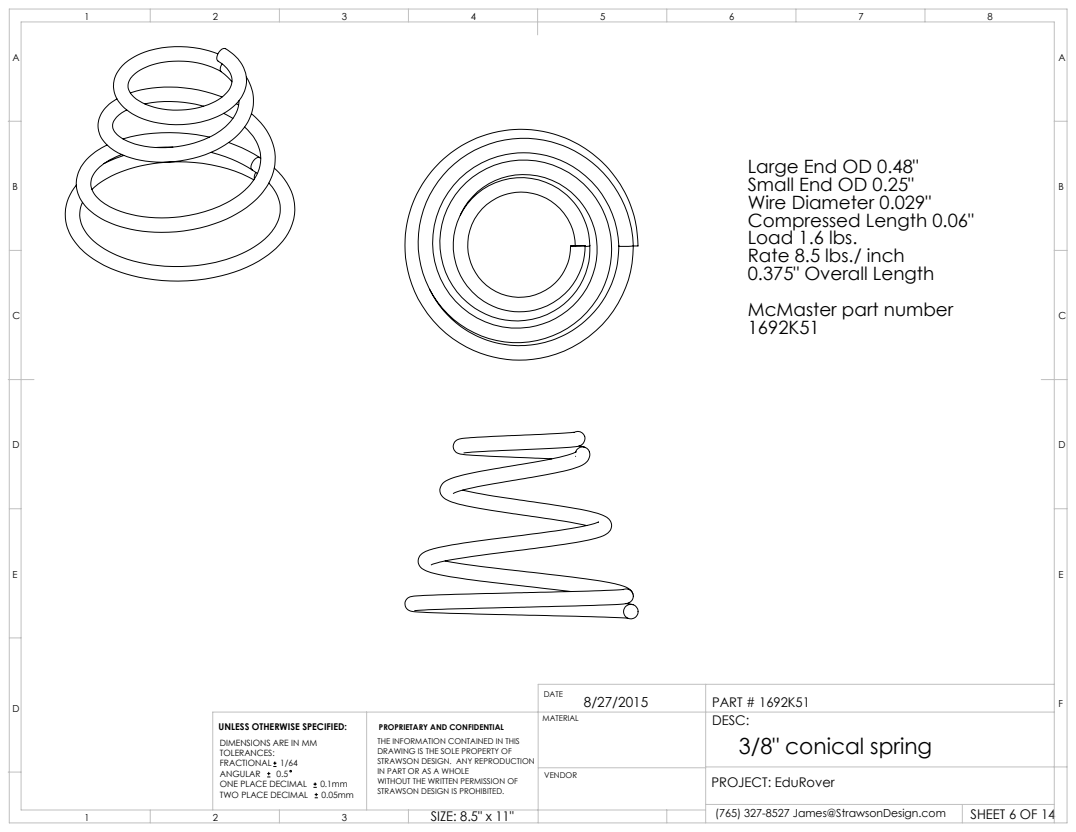
[picture p39: page 6]
SHEET 6 OF 14

Large End OD 0.48"
Small End OD 0.25"
Wire Diameter 0.029"
Compressed Length 0.06"
Load 1.6 lbs.
Rate 8.5 lbs./ inch
0.375" Overall Length
McMaster part number

DATE 8/27/2015 | PART # 1692K51

UNLESS OTHERWISE SPECIFIED: DIMENSIONS ARE IN MM TOLERANCES: FRACTIONAL 1/64 | PROPRIETARY AND CONFIDENTIAL THE INFORMATION CONTAINED IN THIS DRAWING IS THE SOLE PROPERTY OF STRAWSON DESIGN. ANY REPRODUCTION | MATERIAL | DESC: 3/8" conical spring

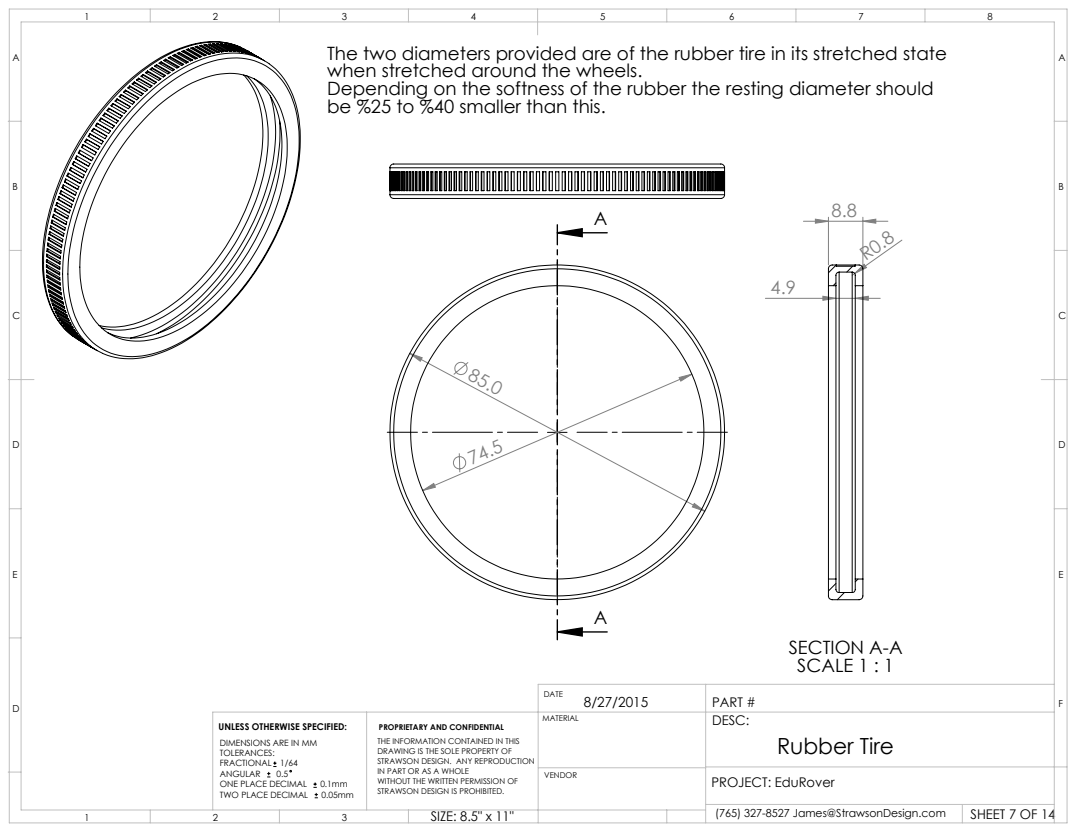
[picture p40: page 7]
SECTION A-A SCALE 1 : 1; SHEET 7 OF 14

The two diameters provided are of the rubber tire in its stretched state
when stretched around the wheels.
Depending on the softness of the rubber the resting diameter should
be %25 to %40 smaller than this.

DATE 8/27/2015 | PART #

UNLESS OTHERWISE SPECIFIED: DIMENSIONS ARE IN MM TOLERANCES: FRACTIONAL 1/64 | PROPRIETARY AND CONFIDENTIAL THE INFORMATION CONTAINED IN THIS DRAWING IS THE SOLE PROPERTY OF STRAWSON DESIGN. ANY REPRODUCTION | MATERIAL | DESC: Rubber Tire

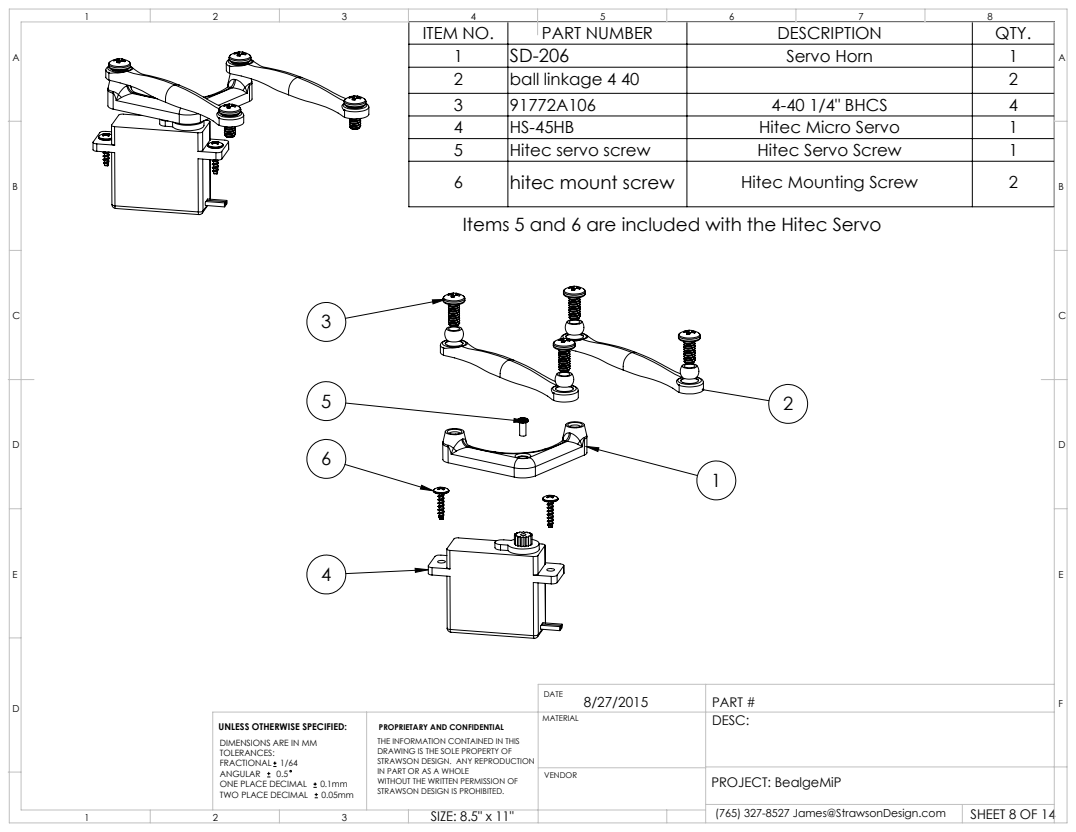
[picture p41: page 8]
SHEET 8 OF 14

1 | SD-206 | Servo Horn | 1
2 | ball linkage 4 40 | | 2
3 | 91772A106 | 4-40 1/4" BHCS | 4
4 | HS-45HB | Hitec Micro Servo | 1
5 | Hitec servo screw | Hitec Servo Screw | 1
6 | hitec mount screw | Hitec Mounting Screw | 2

Items 5 and 6 are included with the Hitec Servo

DATE 8/27/2015 | PART #

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

PROJECT: BealgeMiP

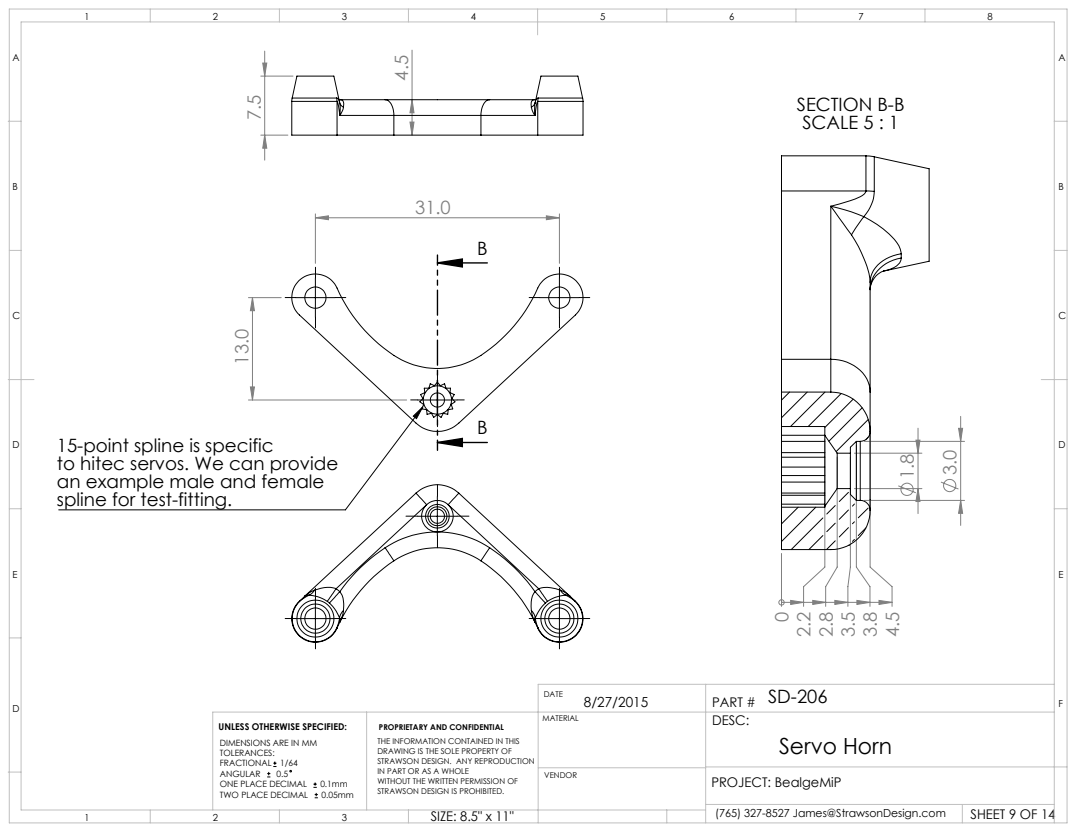
[picture p42: page 9]
SECTION B-B SCALE 5 : 1; SHEET 9 OF 14

15-point spline is specific
to hitec servos. We can provide
an example male and female
spline for test-fitting.

DATE 8/27/2015 | SD-206 PART #

UNLESS OTHERWISE SPECIFIED: DIMENSIONS ARE IN MM TOLERANCES: FRACTIONAL 1/64 | PROPRIETARY AND CONFIDENTIAL THE INFORMATION CONTAINED IN THIS DRAWING IS THE SOLE PROPERTY OF STRAWSON DESIGN. ANY REPRODUCTION | MATERIAL | DESC: Servo Horn

PROJECT: BealgeMiP

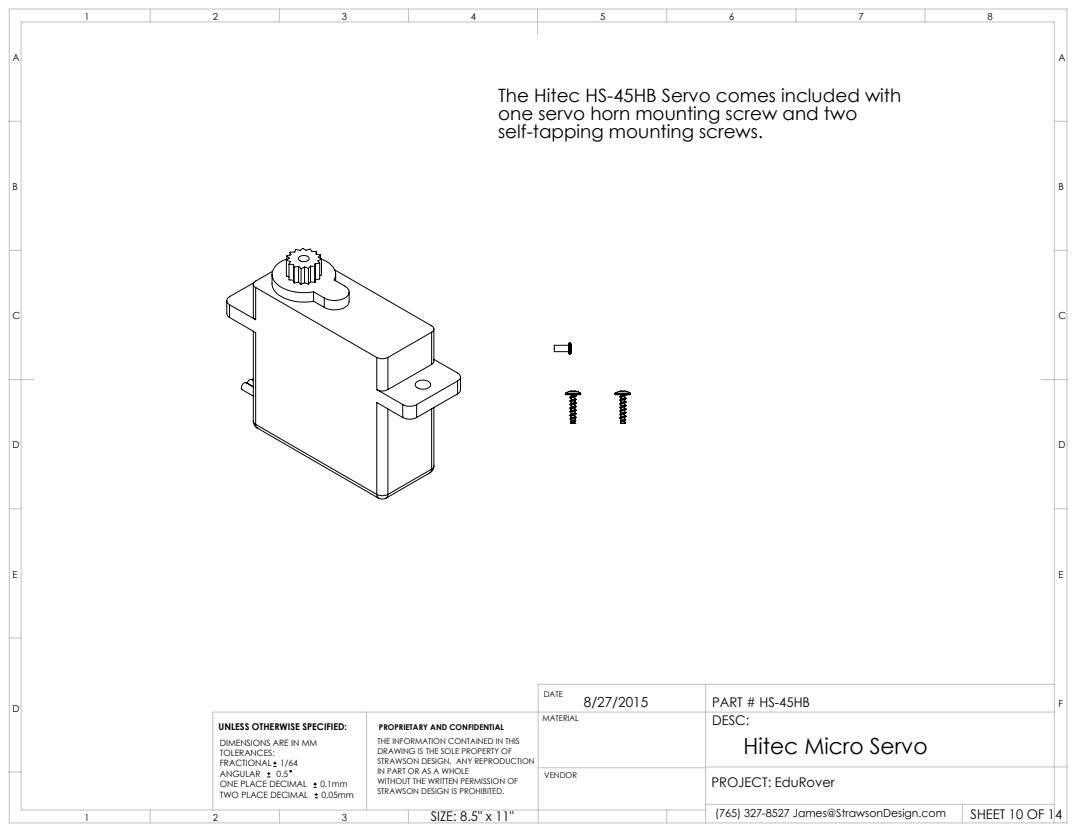
[picture p43: page 10]
SHEET 10 OF 14

The Hitec HS-45HB Servo comes included with
one servo horn mounting screw and two
self-tapping mounting screws.

DATE 8/27/2015 | PART # HS-45HB

UNLESS OTHERWISE SPECIFIED: DIMENSIONS ARE IN MM TOLERANCES: FRACTIONAL 1/64 | PROPRIETARY AND CONFIDENTIAL THE INFORMATION CONTAINED IN THIS DRAWING IS THE SOLE PROPERTY OF STRAWSON DESIGN. ANY REPRODUCTION | MATERIAL | DESC: Hitec Micro Servo

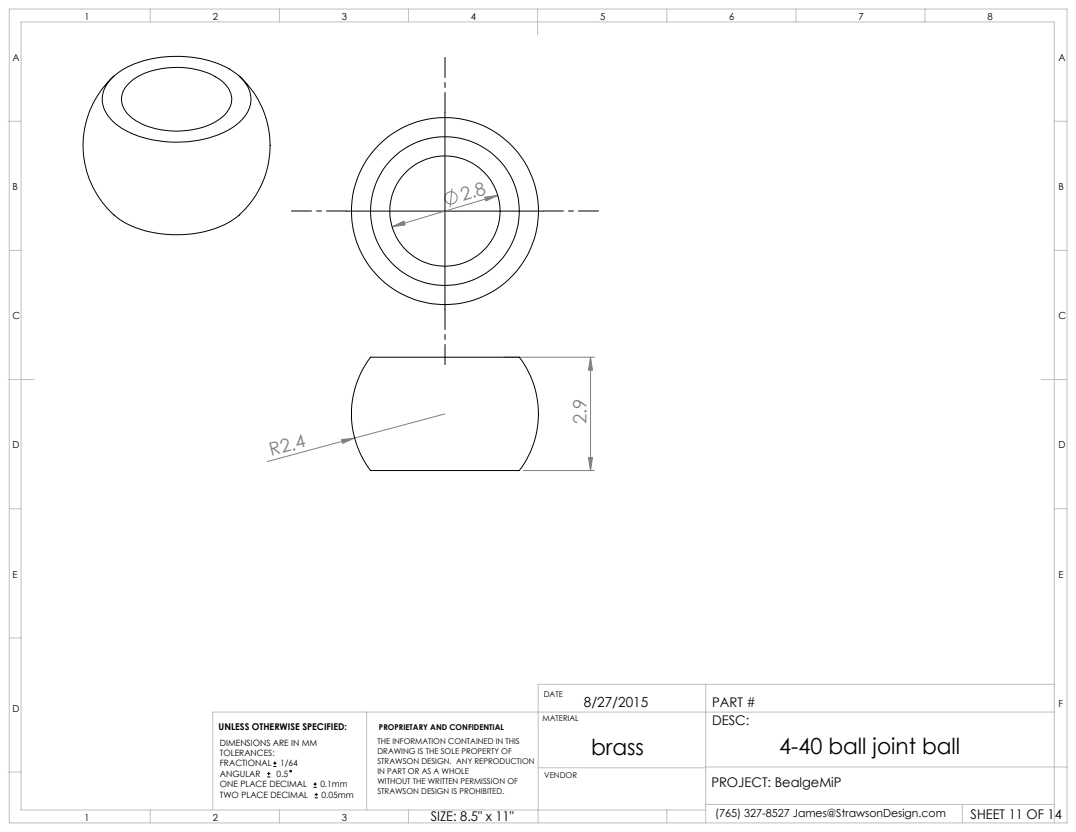
[picture p44: page 11]
SHEET 11 OF 14

DATE 8/27/2015 | PART #

UNLESS OTHERWISE SPECIFIED: DIMENSIONS ARE IN MM TOLERANCES: FRACTIONAL 1/64 | PROPRIETARY AND CONFIDENTIAL THE INFORMATION CONTAINED IN THIS DRAWING IS THE SOLE PROPERTY OF STRAWSON DESIGN. ANY REPRODUCTION | MATERIAL brass | DESC: 4-40 ball joint ball

PROJECT: BealgeMiP

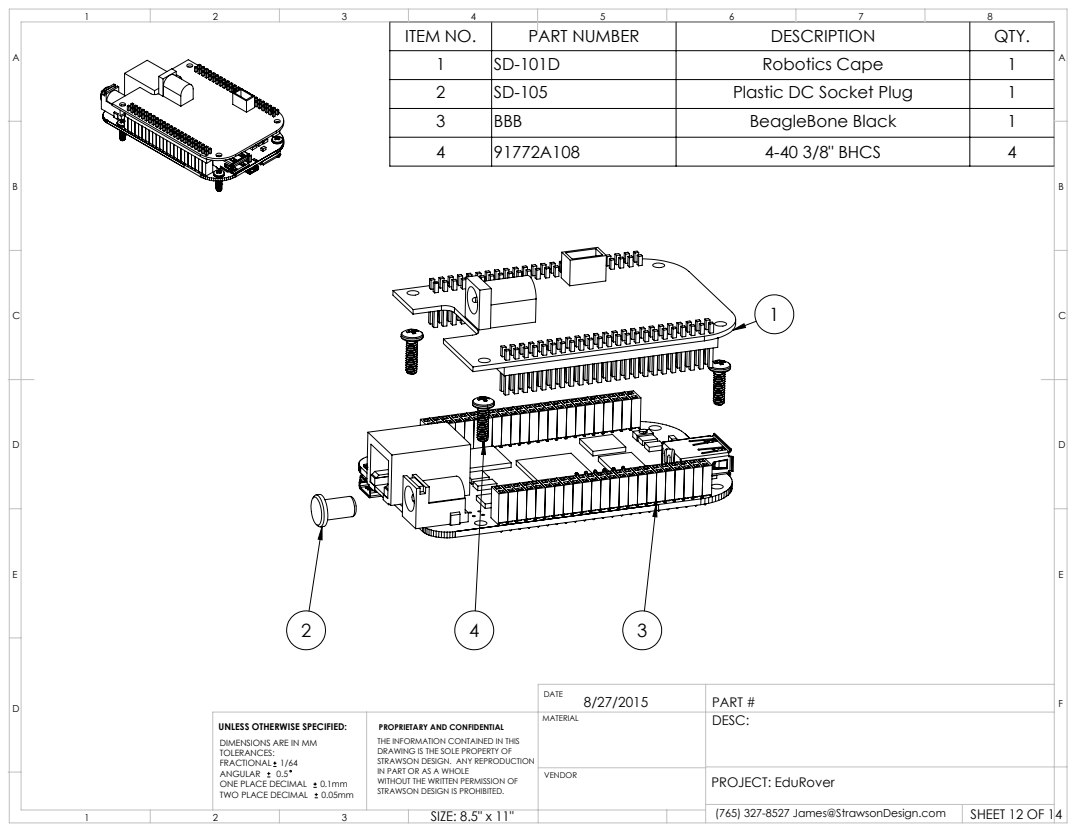
[picture p45: page 12]
SHEET 12 OF 14

1 | SD-101D | Robotics Cape | 1
2 | SD-105 | Plastic DC Socket Plug | 1
3 | BBB | BeagleBone Black | 1
4 | 91772A108 | 4-40 3/8" BHCS | 4

DATE 8/27/2015 | PART #

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

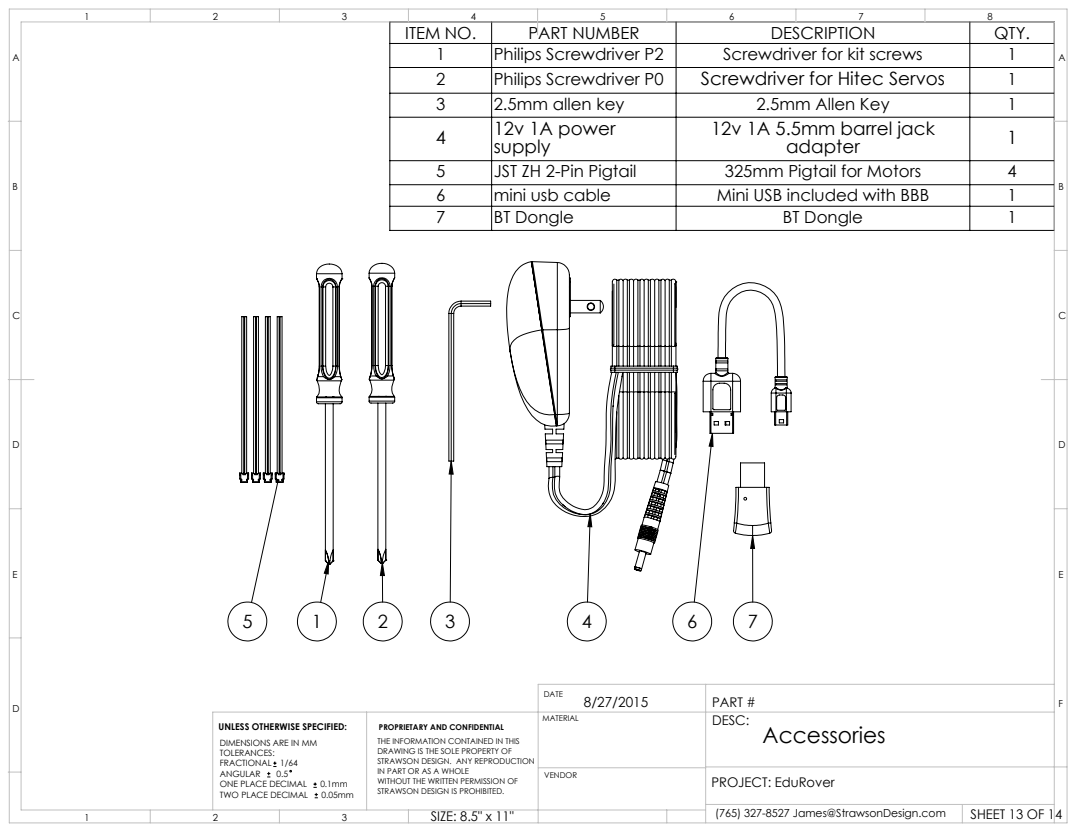
[picture p46: page 13]
SHEET 13 OF 14

1 | Philips Screwdriver P2 | Screwdriver for kit screws | 1
2 | Philips Screwdriver P0 | Screwdriver for Hitec Servos | 1
3 | 2.5mm allen key | 2.5mm Allen Key | 1
4 | 12v 1A power supply | 12v 1A 5.5mm barrel jack adapter | 1

5 | JST ZH 2-Pin Pigtail | 325mm Pigtail for Motors | 4
6 | mini usb cable | Mini USB included with BBB | 1
7 | BT Dongle | BT Dongle | 1

DATE 8/27/2015 | PART #

UNLESS OTHERWISE SPECIFIED: DIMENSIONS ARE IN MM TOLERANCES: FRACTIONAL 1/64 | PROPRIETARY AND CONFIDENTIAL THE INFORMATION CONTAINED IN THIS DRAWING IS THE SOLE PROPERTY OF STRAWSON DESIGN. ANY REPRODUCTION | MATERIAL | DESC: Accessories

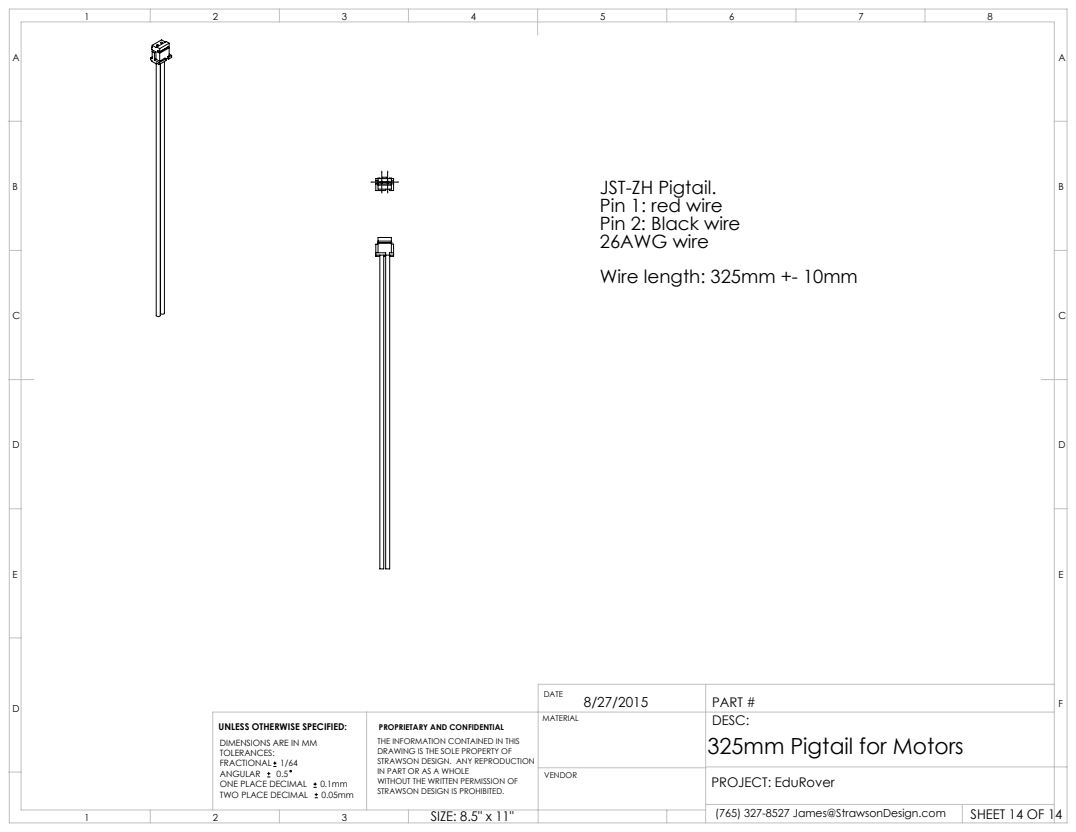
[picture p47: page 14]
SHEET 14 OF 14

JST-ZH Pigtail.
Pin 1: red wire
Pin 2: Black wire
26AWG wire
Wire length: 325mm +- 10mm

DATE 8/27/2015 | PART #

UNLESS OTHERWISE SPECIFIED: DIMENSIONS ARE IN MM TOLERANCES: FRACTIONAL 1/64 | PROPRIETARY AND CONFIDENTIAL THE INFORMATION CONTAINED IN THIS DRAWING IS THE SOLE PROPERTY OF STRAWSON DESIGN. ANY REPRODUCTION | MATERIAL | DESC: 325mm Pigtail for Motors
